enfoquesolarmx/ISLA_DEL_SOL_PUENTE_H-/hardware/puente_h/Disipador_V8511Y_equiv.step

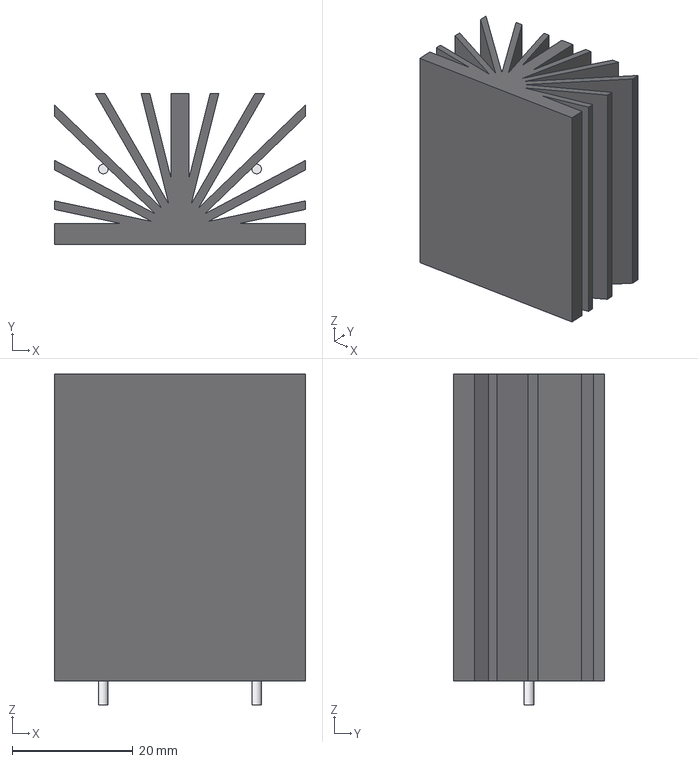
[picture p112: CAD file, 2026-11-05]
hardware/puente_h/Disipador_V8511Y_equiv.step
41.6 x 25.0 x 54.8 mm
disipador
pines
