enfoquesolarmx/ISLA_DEL_SOL_PUENTE_H-/hardware/transferencia_reles/3d/Relay_SPDT_RAYEX-L90S_aprox.step

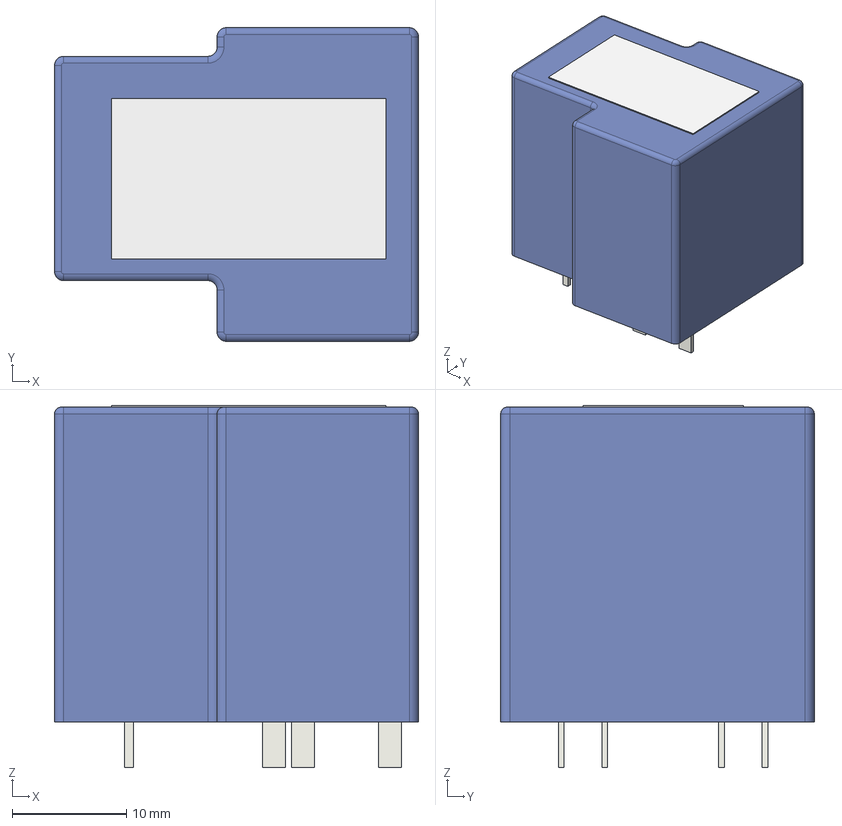
[picture p113: CAD file, 2026-11-11]
hardware/transferencia_reles/3d/Relay_SPDT_RAYEX-L90S_aprox.step
31.8 x 27.4 x 31.6 mm
cuerpo
marca
pines
