enfoquesolarmx/ISLA_DEL_SOL_PUENTE_H-/hardware/puente_h/Heatsink_Fischer_SK129-STS_50.8mm.step

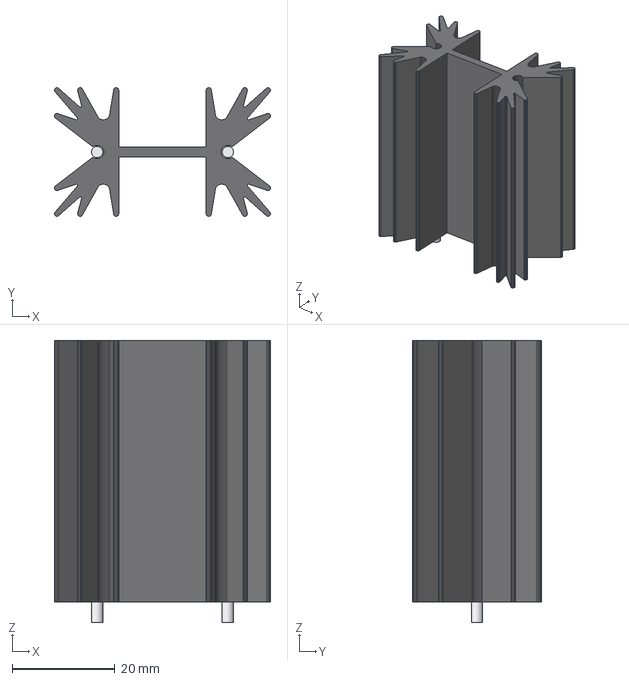
[picture p114: CAD file, 2026-11-05]
hardware/puente_h/Heatsink_Fischer_SK129-STS_50.8mm.step
42.0 x 25.0 x 54.8 mm
disipador
pines
