enfoquesolarmx/ISLA_DEL_SOL_PUENTE_H-/hardware/puente_h/SSA2512_Littelfuse.step

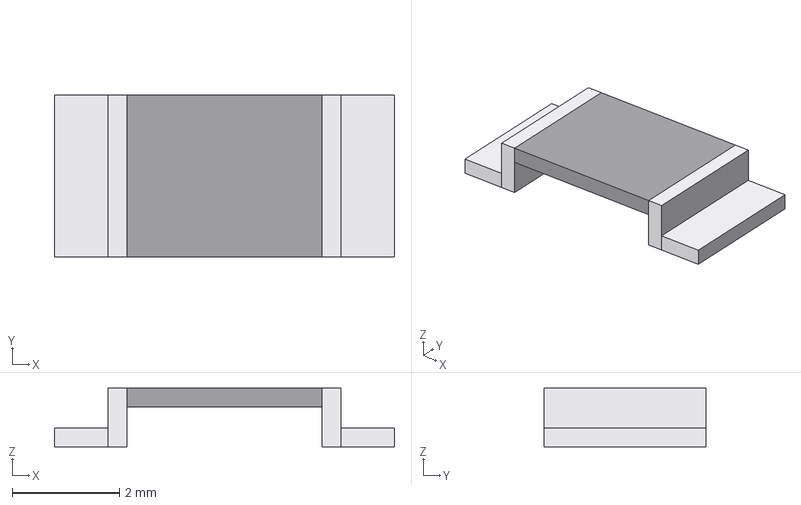
[picture p115: CAD file, 2026-11-05]
hardware/puente_h/SSA2512_Littelfuse.step
6.35 x 3.02 x 1.10 mm
term1
term2
riser1
riser2
elemento
