enfoquesolarmx/ISLA_DEL_SOL_PUENTE_H-/hardware/puente_h/PUENTE_H_INV48V_REV_C_2026-10_GATE_CENTRO.kicad_pcb

## KiCad design hardware/puente_h/PUENTE_H_INV48V_REV_C_2026-10_GATE_CENTRO.kicad_pcb (2026-11-12)

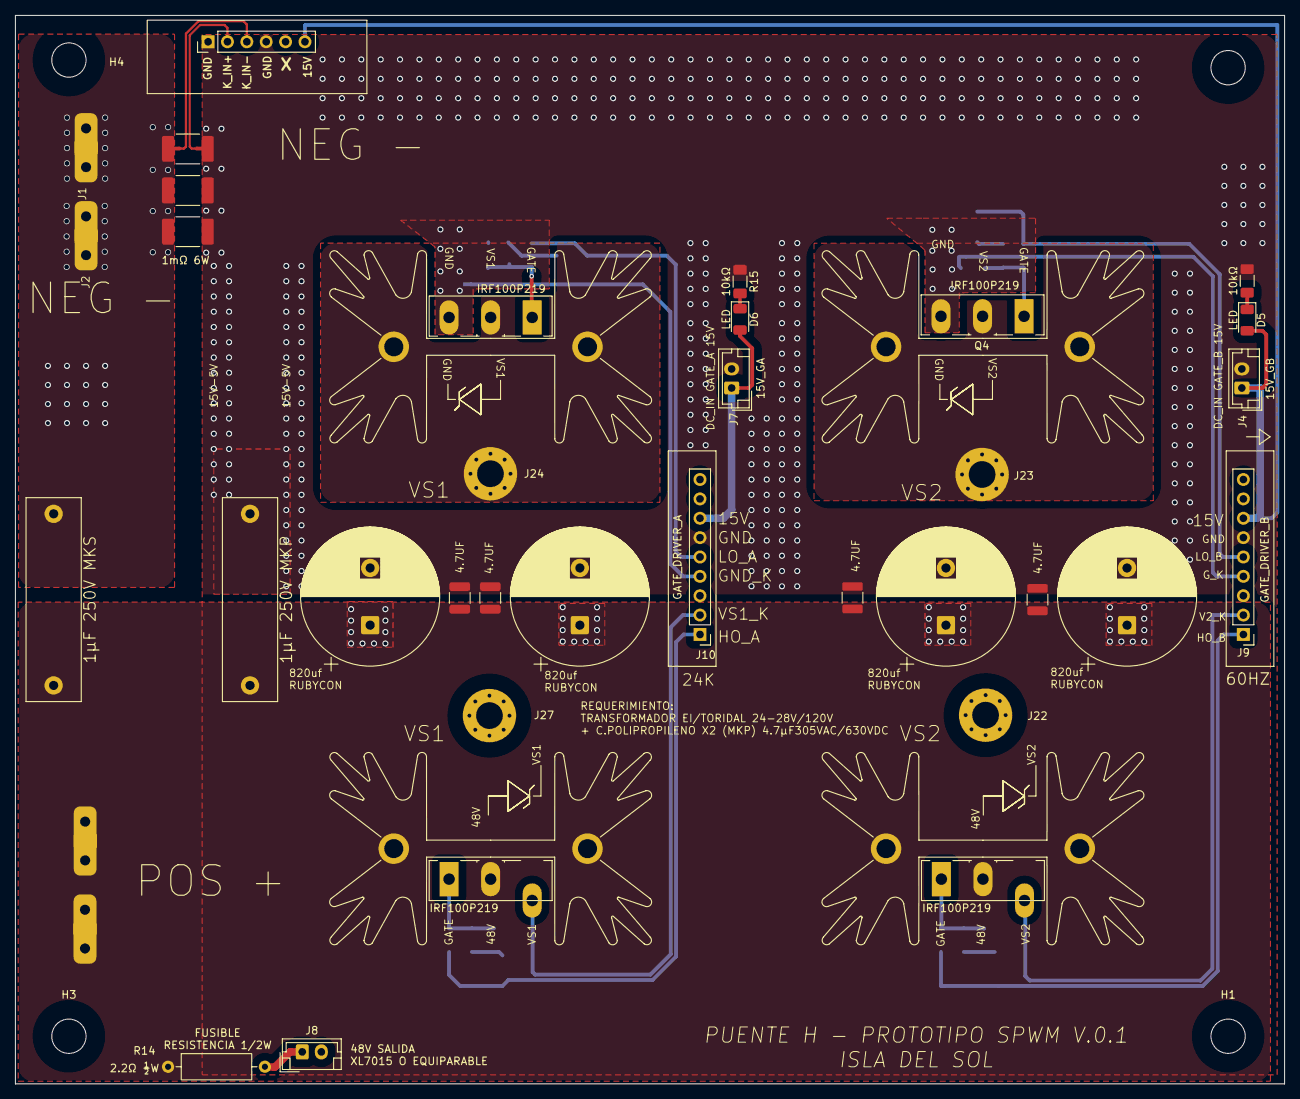
[picture p116: board PUENTE_H_INV48V_REV_C_2026-10_GATE_CENTRO.kicad_pcb from above]

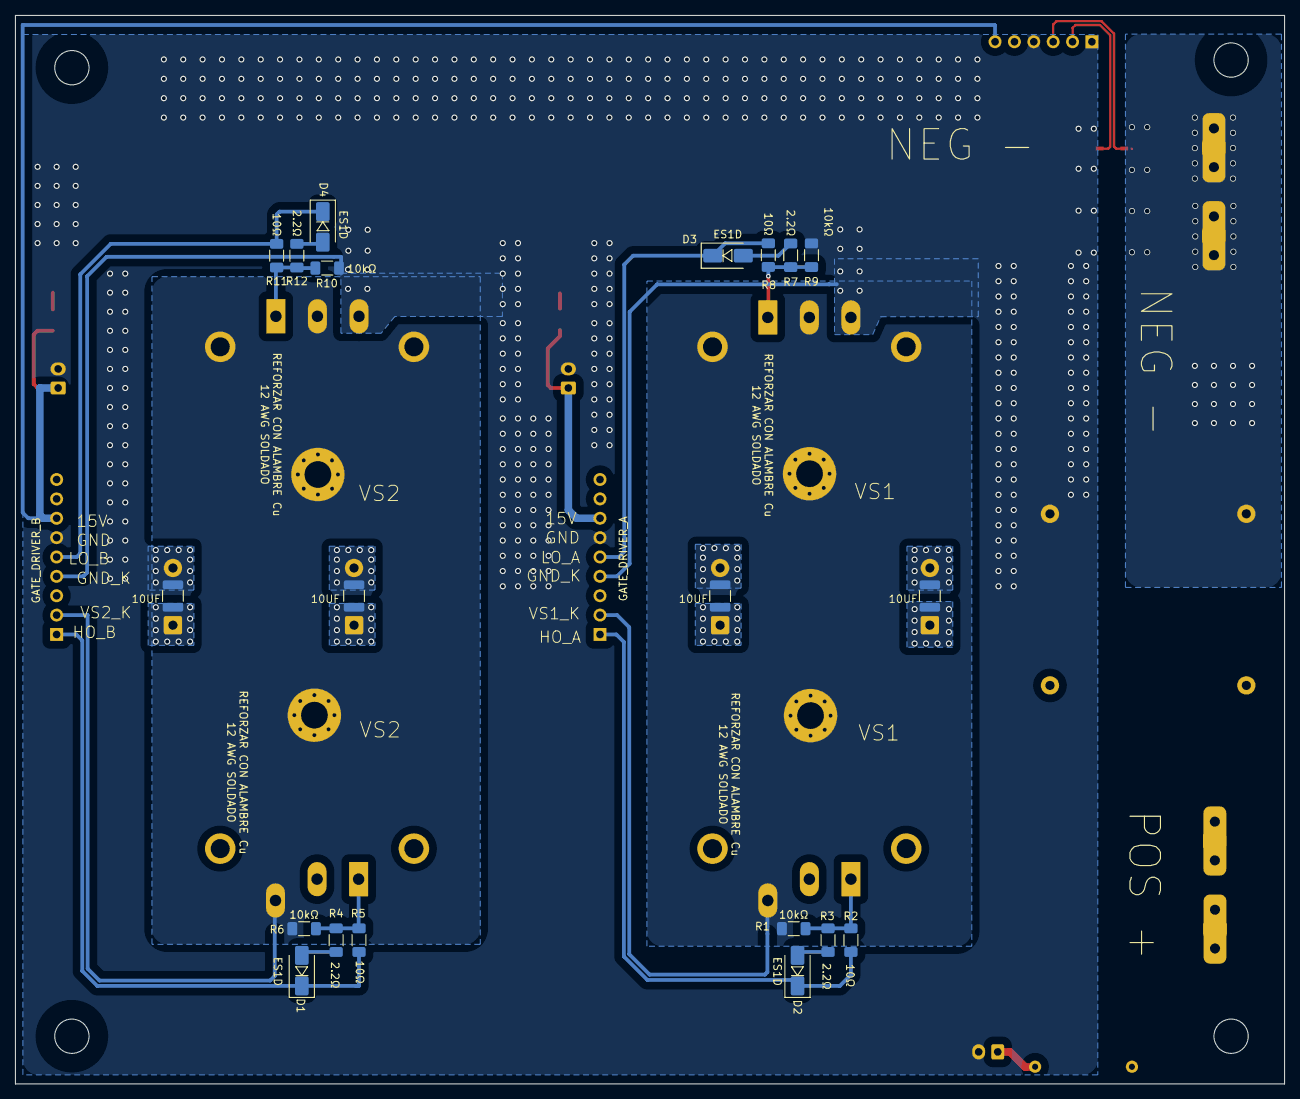
[picture p117: board PUENTE_H_INV48V_REV_C_2026-10_GATE_CENTRO.kicad_pcb from below]

Board: 2 copper layers, 166.4 x 140.1 mm, 70 parts (24 on the bottom side), 28 nets.

Parts:
C1, C2, C3, C4: 820µF 100V Rubycon ZLH; CP_Radial_D18.0mm_P7.50mm
C5, C6, C7, C8: 10µF 100V X7R; C_1210_3225Metric
C9: 1µF 250V MKP; C_Rect_L26.5mm_W7.0mm_P22.50mm_MKS4
C10: 1µF 250V MKS; C_Rect_L26.5mm_W7.0mm_P22.50mm_MKS4
C11, C12, C13, C14: 4.7µF 100V X7R; C_1210_3225Metric
D1, D2, D3, D4: ES1D; D_SMA
D5, D6: LED; LED_1206_3216Metric
H1, H2, H3, H4: MountingHole; MountingHole_4.5mm
HS5: DISIPADOR_1; Heatsink_Fischer_SK129-STS_42x25mm_2xDrill2.5mm
HS6: DISIPADOR_3; Heatsink_Fischer_SK129-STS_42x25mm_2xDrill2.5mm
HS7: DISIPADOR_2; Heatsink_Fischer_SK129-STS_42x25mm_2xDrill2.5mm
HS8: DISIPADOR_4; Heatsink_Fischer_SK129-STS_42x25mm_2xDrill2.5mm
J1, J2: BAT− (GND_IN); Faston 63823
J3: SENSOR_DC (llave en 5); PinHeader_1x06_P2.54mm_Vertical
J4: 15V_GB; JST_EH_B2B-EH-A_1x02_P2.50mm_Vertical
J5, J6: BAT+ (48V); Faston 63823
J7: 15V_GA; JST_EH_B2B-EH-A_1x02_P2.50mm_Vertical
J8: 48V → BUCK (≥80 V); JST_EH_B2B-EH-A_1x02_P2.50mm_Vertical
J9: GATE_DRIVER_B; PinHeader_1x09_P2.54mm_Vertical
J10: GATE_DRIVER_A; PinHeader_1x09_P2.54mm_Vertical
J22, J23: VS2; MountingHole_3.5mm_Pad_Via
J24, J27: VS1; MountingHole_3.5mm_Pad_Via
NT1, NT2, NT3, NT4, NT5, NT6: Kelvin; NetTie-2_SMD_Pad0.5mm
Q1, Q2, Q3, Q4: IRF100P219; TO-247-3_Vertical
R1, R6, R9, R10, R13, R15: 10kΩ; R_1206_3216Metric_Pad1.30x1.75mm_HandSolder
R2, R5, R8, R11: 10Ω; R_1206_3216Metric_Pad1.30x1.75mm_HandSolder
R3, R4, R7, R12: 2.2Ω; R_1206_3216Metric_Pad1.30x1.75mm_HandSolder
R14: 2.2Ω ½W; R_Axial_DIN0309_L9.0mm_D3.2mm_P12.70mm_Horizontal
R16: 1mΩ 6W (Kelvin, siempre); SSA2512_Littelfuse_Kelvin
R17: 1mΩ 6W (opcional); SSA2512_Littelfuse_Kelvin
R28: 1mΩ 6W; SSA2512_Littelfuse_Kelvin

Connections:
15V_GA: D6.2 (A), J7.1, J10.7
15V_GB: D5.2 (A), J3.6, J4.1, J9.7
48V: C1.1, C2.1, C3.1, C4.1, C5.1, C6.1, C7.1, C8.1, C9.1, C10.1, C11.1, C12.1, C13.1, C14.1, HS5.1, HS7.1, J5.1, J6.1, Q1.2 (D), Q3.2 (D), R14.1
GND: C1.2, C2.2, C3.2, C4.2, C5.2, C6.2, C7.2, C8.2, C9.2, C11.2, C12.2, C13.2, C14.2, J3.1, J3.4, J4.2, J7.2, J8.2, J9.6, J10.6, NT1.2, NT2.2, NT5.2, Q2.3 (S), Q4.3 (S), R9.2, R10.2, R13.1, R15.1, R16.2, R17.2, R28.2
GND_IN: C10.2, J1.1, J2.1, NT6.2, R16.1, R17.1, R28.1
GND_KELVIN_A: J10.4, NT2.1
GND_KELVIN_B: J9.4, NT1.1
HO_A: D2.1 (K), J10.1, R2.1
HO_B: D1.1 (K), J9.1, R5.1
IN+ (Kelvin): J3.2, NT5.1
IN- (Kelvin): J3.3, NT6.1
LO_A: D3.1 (K), J10.5, R8.1
LO_B: D4.1 (K), J9.5, R11.1
unnamed: D1.2 (A), R4.1
unnamed: D2.2 (A), R3.1
unnamed: D3.2 (A), R7.1
unnamed: D4.2 (A), R12.1
unnamed: D5.1 (K), R13.2
unnamed: D6.1 (K), R15.2
unnamed: J8.1, R14.2
unnamed: Q1.1 (G), R1.1, R2.2, R3.2
unnamed: Q2.1 (G), R7.2, R8.2, R9.1
unnamed: Q3.1 (G), R4.2, R5.2, R6.1
unnamed: Q4.1 (G), R10.1, R11.2, R12.2
VS1: HS6.1, J24.1, J27.1, NT4.2, Q1.3 (S), Q2.2 (D), R1.2
VS1_k: J10.2, NT4.1
VS2: HS8.1, J22.1, J23.1, NT3.2, Q3.3 (S), Q4.2 (D), R6.2
VS2_k: J9.2, NT3.1
