enfoquesolarmx/ISLA_DEL_SOL_PUENTE_H-/hardware/gate-drivers/ucc21520/GATE_DRIVER_UCC21520.kicad_pcb

## KiCad design hardware/gate-drivers/ucc21520/GATE_DRIVER_UCC21520.kicad_pcb (2026-11-12)

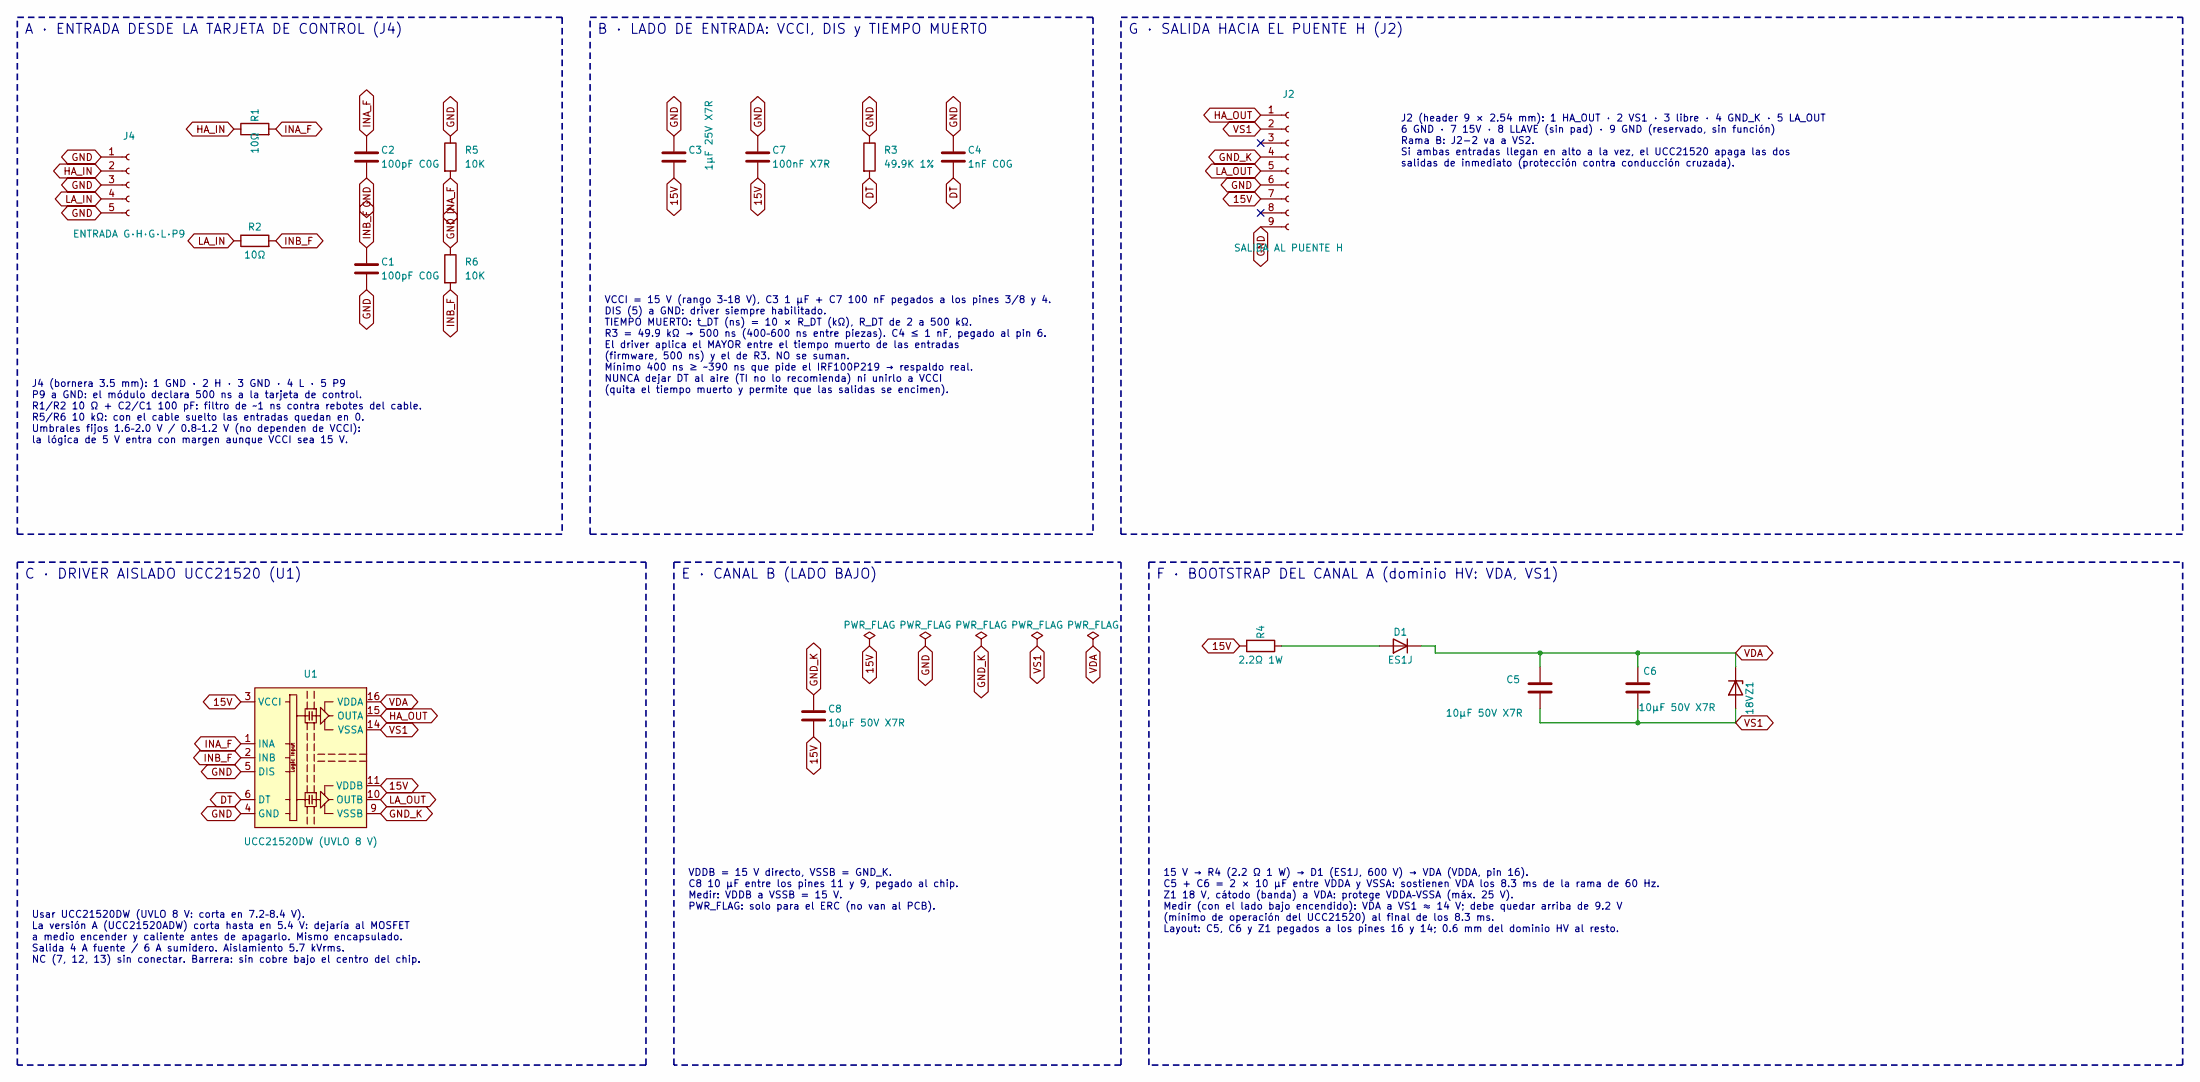
[picture p118: schematic GATE_DRIVER_UCC21520.kicad_sch]

Parts:
C1, C2: 100pF C0G; C_1206_3216Metric
C3: 1µF 25V X7R; C_1206_3216Metric
C4: 1nF C0G; C_1206_3216Metric
C5, C6, C8: 10µF 50V X7R; C_1206_3216Metric
C7: 100nF X7R; C_1206_3216Metric
D1: ES1J; D_SMA
J2: SALIDA AL PUENTE H; PinHeader_1x09_P2.54mm_Vertical
J4: ENTRADA G·H·G·L·P9; PhoenixContact_SPT_1.5_5-H-3.5_1x05_P3.5mm_Horizontal
R1, R2: 10Ω; R_1206_3216Metric
R3: 49.9K 1%; R_1206_3216Metric
R4: 2.2Ω 1W; R_1210_3225Metric_Pad1.30x2.65mm_HandSolder
R5, R6: 10K; R_1206_3216Metric
U1: UCC21520DW (UVLO 8 V); SOIC-16W_7.5x10.3mm_P1.27mm
Z1: 18V; D_SMA

Connections:
15V: C3.2, C7.2, C8.2, J2.7, R4.2, U1.3 (VCCI), U1.8 (VCCI), U1.11 (VDDB)
DT: C4.2, R3.2, U1.6 (DT)
GND: C1.2, C2.2, C3.1, C4.1, C7.1, J2.6, J2.9, J4.1, J4.3, J4.5, R3.1, R5.1, R6.1, U1.4 (GND), U1.5 (DIS)
GND_K: C8.1, J2.4, U1.9 (VSSB)
HA_IN: J4.2, R1.1
HA_OUT: J2.1, U1.15 (OUTA)
INA_F: C2.1, R1.2, R5.2, U1.1 (INA)
INB_F: C1.1, R2.2, R6.2, U1.2 (INB)
LA_IN: J4.4, R2.1
LA_OUT: J2.5, U1.10 (OUTB)
unnamed: D1.2 (A), R4.1
VDA: C5.2, C6.2, D1.1 (K), U1.16 (VDDA), Z1.1 (K)
VS1: C5.1, C6.1, J2.2, U1.14 (VSSA), Z1.2 (A)

Notes on the sheet:
VCCI = 15 V (rango 3–18 V), C3 1 µF + C7 100 nF pegados a los pines 3/8 y 4. DIS (5) a GND: driver siempre habilitado. TIEMPO MUERTO: t_DT (ns) = 10 × R_DT (kΩ), R_DT de 2 a 500 kΩ. R3 = 49.9 kΩ → 500 ns (400–600 ns entre piezas). C4 ≤ 1 nF, pegado al pin 6. El driver aplica el MAYOR entre el tiemp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
15 V → R4 (2.2 Ω 1 W) → D1 (ES1J, 600 V) → VDA (VDDA, pin 16). C5 + C6 = 2 × 10 µF entre VDDA y VSSA: sostienen VDA los 8.3 ms de la rama de 60 Hz. Z1 18 V, cátodo (banda) a VDA: protege VDDA–VSSA (máx. 25 V). Medir (con el lado bajo encendido): VDA a VS1 ≈ 14 V; debe quedar arriba de 9.2 V (mínimo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
B · LADO DE ENTRADA: VCCI, DIS y TIEMPO MUERTO
A · ENTRADA DESDE LA TARJETA DE CONTROL (J4)
J2 (header 9 × 2.54 mm): 1 HA_OUT · 2 VS1 · 3 libre · 4 GND_K · 5 LA_OUT 6 GND · 7 15V · 8 LLAVE (sin pad) · 9 GND (reservado, sin función) Rama B: J2-2 va a VS2. Si ambas entradas llegan en alto a la vez, el UCC21520 apaga las dos salidas de inmediato (protección contra conducción cruzada).
F · BOOTSTRAP DEL CANAL A (dominio HV: VDA, VS1)
E · CANAL B (LADO BAJO)
VDDB = 15 V directo, VSSB = GND_K. C8 10 µF entre los pines 11 y 9, pegado al chip. Medir: VDDB a VSSB = 15 V. PWR_FLAG: solo para el ERC (no van al PCB).
C · DRIVER AISLADO UCC21520 (U1)
J4 (bornera 3.5 mm): 1 GND · 2 H · 3 GND · 4 L · 5 P9 P9 a GND: el módulo declara 500 ns a la tarjeta de control. R1/R2 10 Ω + C2/C1 100 pF: filtro de ~1 ns contra rebotes del cable. R5/R6 10 kΩ: con el cable suelto las entradas quedan en 0. Umbrales fijos 1.6–2.0 V / 0.8–1.2 V (no dependen de VCCI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
Usar UCC21520DW (UVLO 8 V: corta en 7.2–8.4 V). La versión A (UCC21520ADW) corta hasta en 5.4 V: dejaría al MOSFET a medio encender y caliente antes de apagarlo. Mismo encapsulado. Salida 4 A fuente / 6 A sumidero. Aislamiento 5.7 kVrms. NC (7, 12, 13) sin conectar. Barrera: sin cobre bajo el centr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
G · SALIDA HACIA EL PUENTE H (J2)

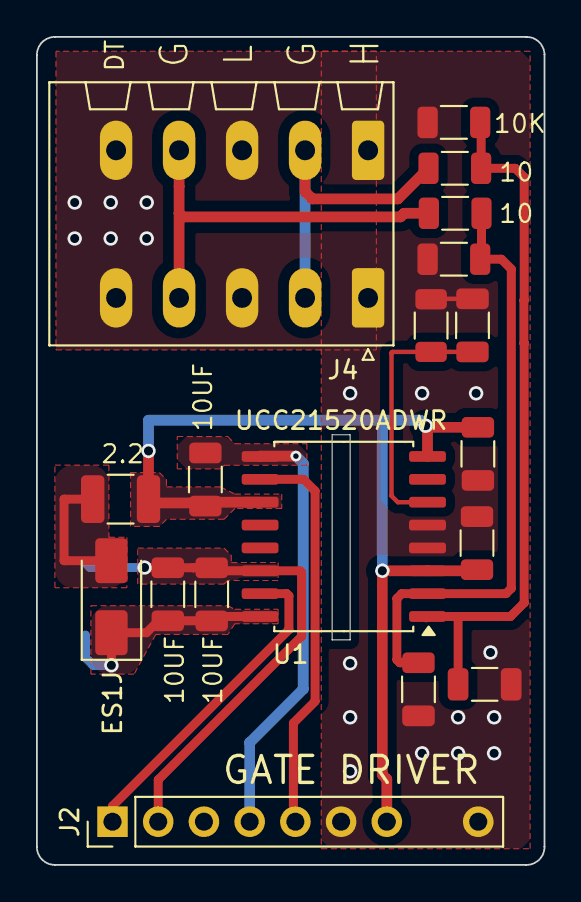
[picture p119: board GATE_DRIVER_UCC21520.kicad_pcb from above]

Board: 2 copper layers, 28.2 x 46.0 mm, 19 parts (1 on the bottom side), 13 nets.
