enfoquesolarmx/ISLA_DEL_SOL_PUENTE_H-/hardware/gate-drivers/tlp250-trinchera/GATE_TLP_250_TOTEM_TIP.kicad_pcb

## KiCad design hardware/gate-drivers/tlp250-trinchera/GATE_TLP_250_TOTEM_TIP.kicad_pcb (2026-11-12)

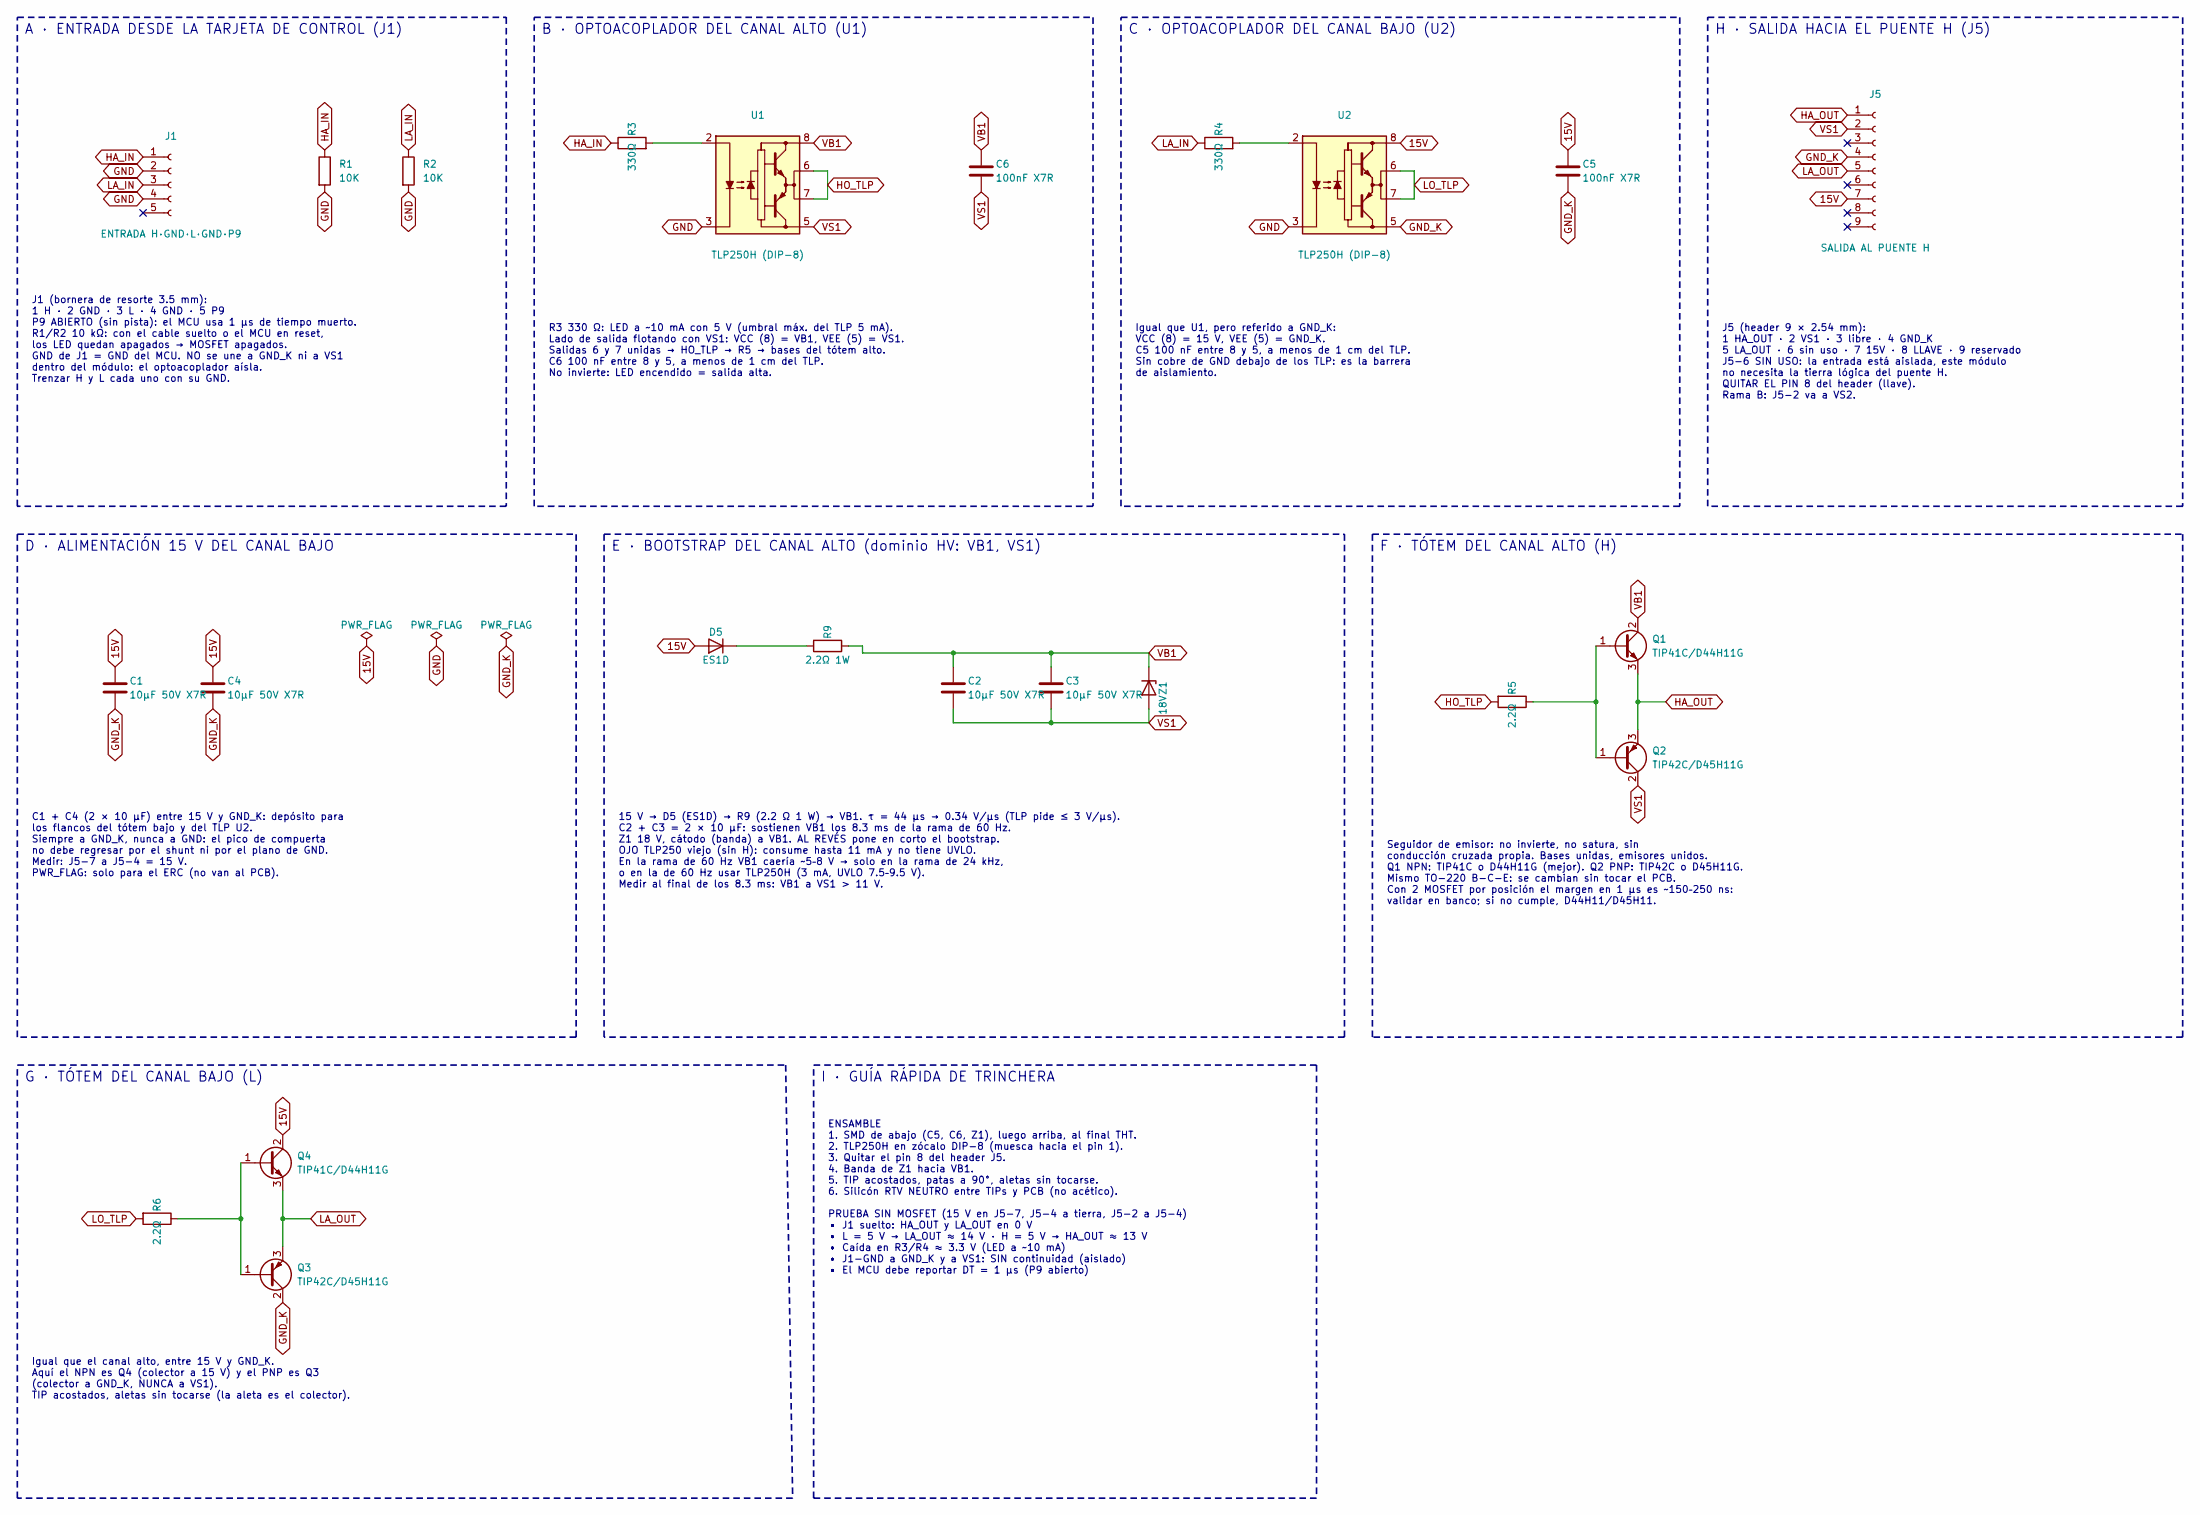
[picture p120: schematic GATE_TLP_250_TOTEM_TIP.kicad_sch]

Parts:
C1, C2, C3, C4: 10µF 50V X7R; C_1206_3216Metric
C5, C6: 100nF X7R; C_1206_3216Metric
D5: ES1D; D_SMA
J1: ENTRADA H·GND·L·GND·P9; PhoenixContact_SPT_1.5_5-H-3.5_1x05_P3.5mm_Horizontal
J5: SALIDA AL PUENTE H; PinHeader_1x09_P2.54mm_Vertical
Q1, Q4: TIP41C/D44H11G; TO-220-3_Vertical
Q2, Q3: TIP42C/D45H11G; TO-220-3_Vertical
R1, R2: 10K; R_1206_3216Metric_Pad1.30x1.75mm_HandSolder
R3, R4: 330Ω; R_1206_3216Metric_Pad1.30x1.75mm_HandSolder
R5, R6: 2.2Ω; R_1206_3216Metric_Pad1.30x1.75mm_HandSolder
R9: 2.2Ω 1W; R_1210_3225Metric
U1, U2: TLP250H (DIP-8); DIP-8_W7.62mm
Z1: 18V; D_SMA

Connections:
15V: C1.1, C4.1, C5.1, D5.2 (A), J5.7, Q4.2 (C), U2.8 (VCC)
GND: J1.2, J1.4, R1.2, R2.2, U1.3 (C), U2.3 (C)
GND_K: C1.2, C4.2, C5.2, J5.4, Q3.2 (C), U2.5 (VEE)
HA_IN: J1.1, R1.1, R3.1
HA_OUT: J5.1, Q1.3 (E), Q2.3 (E)
HO_TLP: R5.2, U1.6 (VO), U1.7 (VO)
LA_IN: J1.3, R2.1, R4.1
LA_OUT: J5.5, Q3.3 (E), Q4.3 (E)
LO_TLP: R6.2, U2.6 (VO), U2.7 (VO)
unnamed: D5.1 (K), R9.2
unnamed: Q1.1 (B), Q2.1 (B), R5.1
unnamed: Q3.1 (B), Q4.1 (B), R6.1
unnamed: R3.2, U1.2 (A)
unnamed: R4.2, U2.2 (A)
VB1: C2.1, C3.1, C6.1, Q1.2 (C), R9.1, U1.8 (VCC), Z1.1 (K)
VS1: C2.2, C3.2, C6.2, J5.2, Q2.2 (C), U1.5 (VEE), Z1.2 (A)

Notes on the sheet:
H · SALIDA HACIA EL PUENTE H (J5)
J5 (header 9 × 2.54 mm): 1 HA_OUT · 2 VS1 · 3 libre · 4 GND_K 5 LA_OUT · 6 sin uso · 7 15V · 8 LLAVE · 9 reservado J5-6 SIN USO: la entrada está aislada, este módulo no necesita la tierra lógica del puente H. QUITAR EL PIN 8 del header (llave). Rama B: J5-2 va a VS2.
C1 + C4 (2 × 10 µF) entre 15 V y GND_K: depósito para los flancos del tótem bajo y del TLP U2. Siempre a GND_K, nunca a GND: el pico de compuerta no debe regresar por el shunt ni por el plano de GND. Medir: J5-7 a J5-4 = 15 V. PWR_FLAG: solo para el ERC (no van al PCB).
A · ENTRADA DESDE LA TARJETA DE CONTROL (J1)
D · ALIMENTACIÓN 15 V DEL CANAL BAJO
E · BOOTSTRAP DEL CANAL ALTO (dominio HV: VB1, VS1)
15 V → D5 (ES1D) → R9 (2.2 Ω 1 W) → VB1. τ = 44 µs → 0.34 V/µs (TLP pide ≤ 3 V/µs). C2 + C3 = 2 × 10 µF: sostienen VB1 los 8.3 ms de la rama de 60 Hz. Z1 18 V, cátodo (banda) a VB1. AL REVÉS pone en corto el bootstrap. OJO TLP250 viejo (sin H): consume hasta 11 mA y no tiene UVLO. En la rama de 60 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
Igual que el canal alto, entre 15 V y GND_K. Aquí el NPN es Q4 (colector a 15 V) y el PNP es Q3 (colector a GND_K, NUNCA a VS1). TIP acostados, aletas sin tocarse (la aleta es el colector).
J1 (bornera de resorte 3.5 mm): 1 H · 2 GND · 3 L · 4 GND · 5 P9 P9 ABIERTO (sin pista): el MCU usa 1 µs de tiempo muerto. R1/R2 10 kΩ: con el cable suelto o el MCU en reset, los LED quedan apagados → MOSFET apagados. GND de J1 = GND del MCU. NO se une a GND_K ni a VS1 dentro del módulo: el optoaco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
F · TÓTEM DEL CANAL ALTO (H)
B · OPTOACOPLADOR DEL CANAL ALTO (U1)
ENSAMBLE 1. SMD de abajo (C5, C6, Z1), luego arriba, al final THT. 2. TLP250H en zócalo DIP-8 (muesca hacia el pin 1). 3. Quitar el pin 8 del header J5. 4. Banda de Z1 hacia VB1. 5. TIP acostados, patas a 90°, aletas sin tocarse. 6. Silicón RTV NEUTRO entre TIPs y PCB (no acético). PRUEBA SIN MOSFE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
C · OPTOACOPLADOR DEL CANAL BAJO (U2)
Igual que U1, pero referido a GND_K: VCC (8) = 15 V, VEE (5) = GND_K. C5 100 nF entre 8 y 5, a menos de 1 cm del TLP. Sin cobre de GND debajo de los TLP: es la barrera de aislamiento.
R3 330 Ω: LED a ~10 mA con 5 V (umbral máx. del TLP 5 mA). Lado de salida flotando con VS1: VCC (8) = VB1, VEE (5) = VS1. Salidas 6 y 7 unidas → HO_TLP → R5 → bases del tótem alto. C6 100 nF entre 8 y 5, a menos de 1 cm del TLP. No invierte: LED encendido = salida alta.
I · GUÍA RÁPIDA DE TRINCHERA
G · TÓTEM DEL CANAL BAJO (L)
Seguidor de emisor: no invierte, no satura, sin conducción cruzada propia. Bases unidas, emisores unidos. Q1 NPN: TIP41C o D44H11G (mejor). Q2 PNP: TIP42C o D45H11G. Mismo TO-220 B-C-E: se cambian sin tocar el PCB. Con 2 MOSFET por posición el margen en 1 µs es ~150–250 ns: validar en banco; si no 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

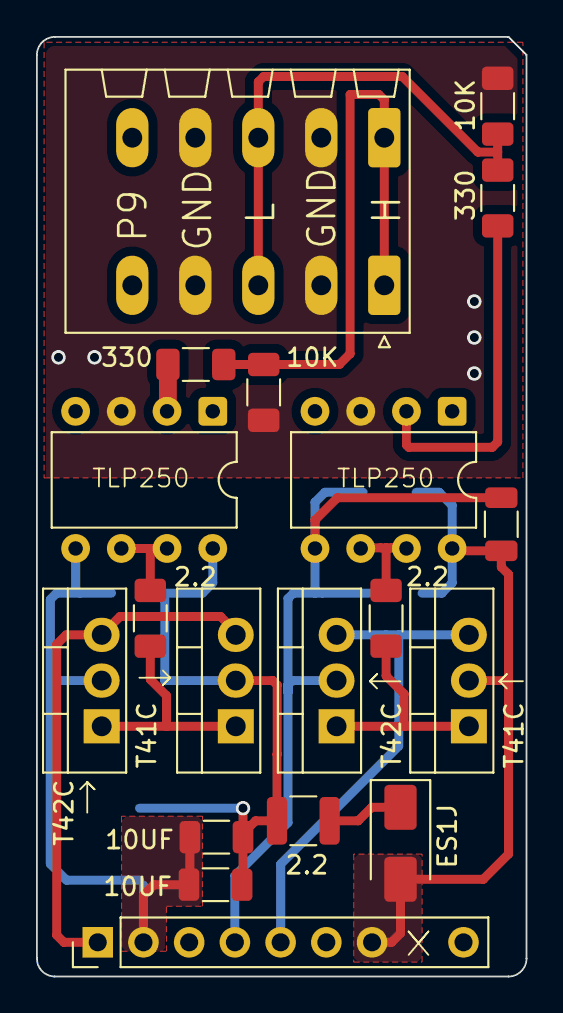
[picture p121: board GATE_TLP_250_TOTEM_TIP.kicad_pcb from above]

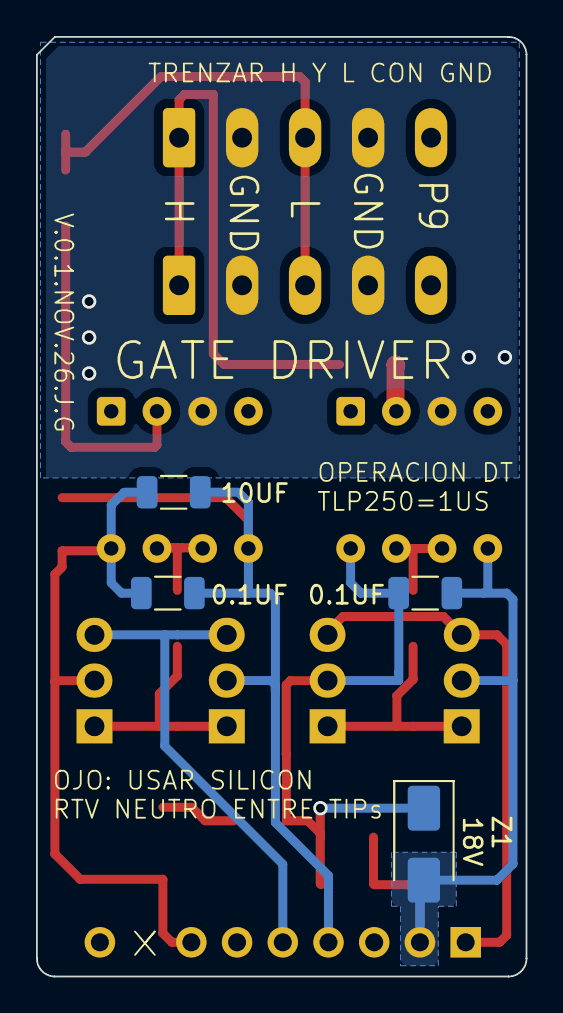
[picture p122: board GATE_TLP_250_TOTEM_TIP.kicad_pcb from below]

Board: 2 copper layers, 27.2 x 52.2 mm, 23 parts (4 on the bottom side), 16 nets.
