enfoquesolarmx/ISLA_DEL_SOL_PUENTE_H-/hardware/gate-drivers/ir2110-trinchera/GATE_DRIVER_IR2110_TOTEM.kicad_pcb

## KiCad design hardware/gate-drivers/ir2110-trinchera/GATE_DRIVER_IR2110_TOTEM.kicad_pcb (2026-11-12)

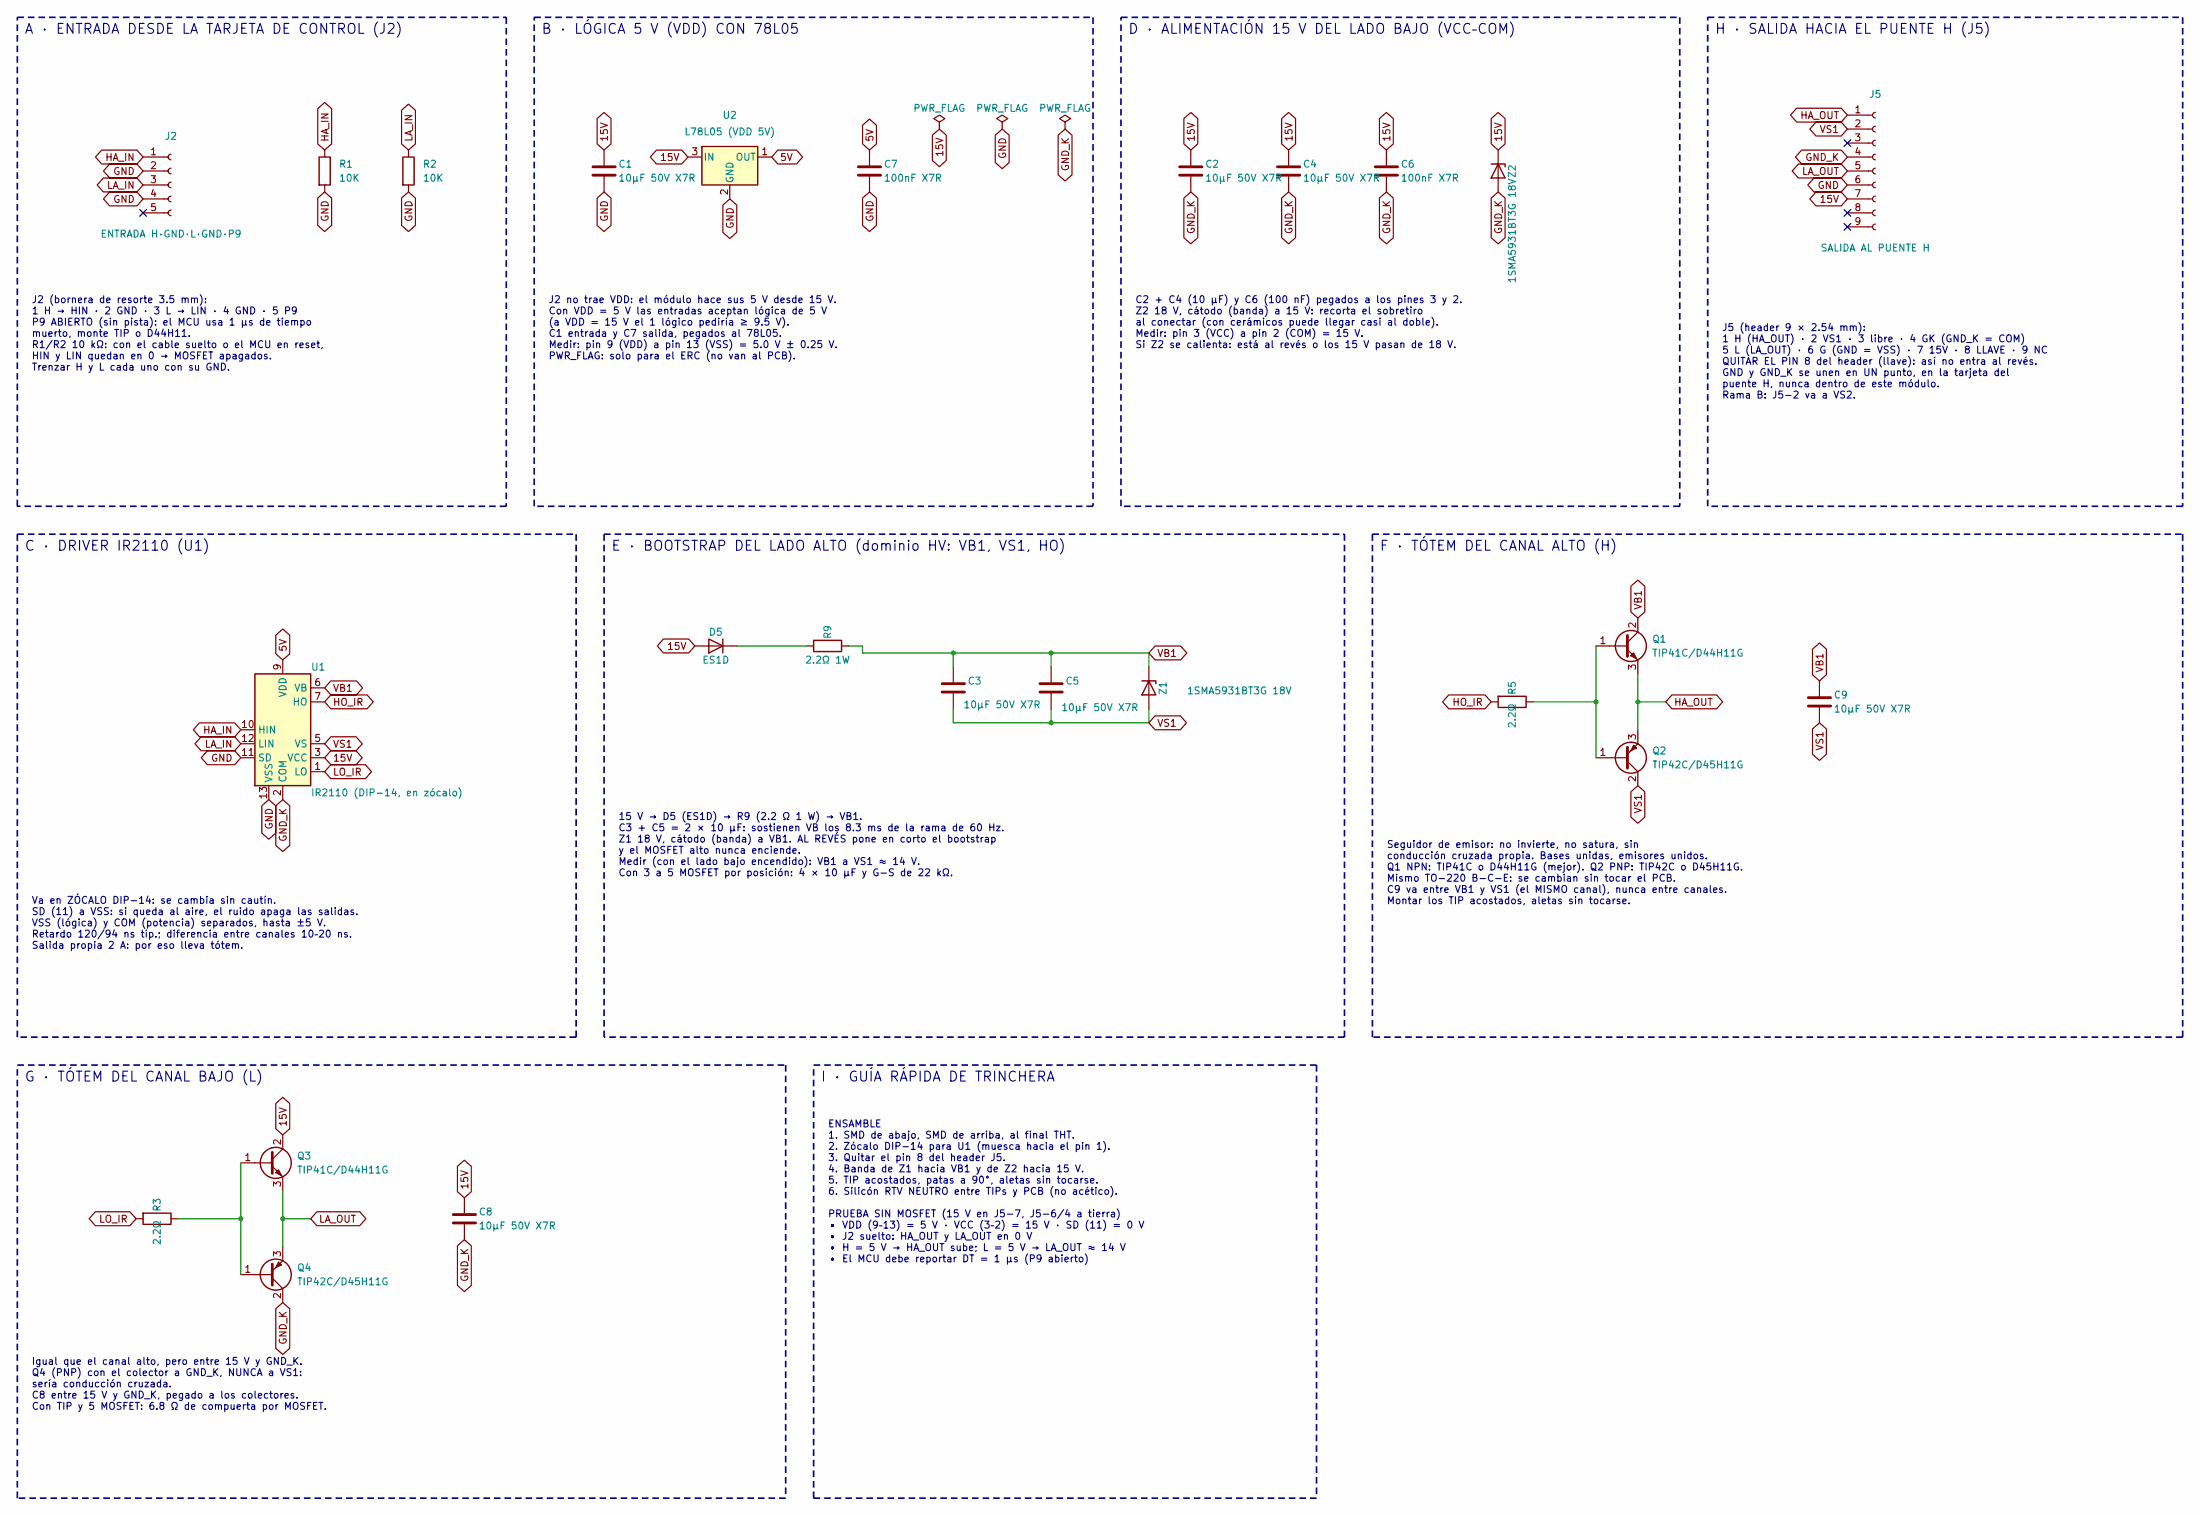
[picture p123: schematic GATE_DRIVER_IR2110_TOTEM.kicad_sch]

Parts:
C1, C2, C3, C4, C5, C8, C9: 10µF 50V X7R; C_1210_3225Metric_Pad1.33x2.70mm_HandSolder
C6, C7: 100nF X7R; C_1206_3216Metric
D5: ES1D; D_SMA
J2: ENTRADA H·GND·L·GND·P9; PhoenixContact_SPT_1.5_5-H-3.5_1x05_P3.5mm_Horizontal
J5: SALIDA AL PUENTE H; PinHeader_1x09_P2.54mm_Vertical
Q1, Q3: TIP41C/D44H11G; TO-220-3_Vertical
Q2, Q4: TIP42C/D45H11G; TO-220-3_Vertical
R1, R2: 10K; R_1206_3216Metric_Pad1.30x1.75mm_HandSolder
R3, R5: 2.2Ω; R_1206_3216Metric_Pad1.30x1.75mm_HandSolder
R9: 2.2Ω 1W; R_1210_3225Metric
U1: IR2110 (DIP-14, en zócalo); DIP-14_W7.62mm
U2: L78L05 (VDD 5V); SOT-89-3
Z1, Z2: 1SMA5931BT3G 18V; D_SMA

Connections:
5V: C7.1, U1.9 (VDD), U2.1 (OUT)
15V: C1.1, C2.1, C4.1, C6.1, C8.1, D5.2 (A), J5.7, Q3.2 (C), U1.3 (VCC), U2.3 (IN), Z2.1 (K)
GND: C1.2, C7.2, J2.2, J2.4, J5.6, R1.2, R2.2, U1.11 (SD), U1.13 (VSS), U2.2 (GND)
GND_K: C2.2, C4.2, C6.2, C8.2, J5.4, Q4.2 (C), U1.2 (COM), Z2.2 (A)
HA_IN: J2.1, R1.1, U1.10 (HIN)
HA_OUT: J5.1, Q1.3 (E), Q2.3 (E)
HO_IR: R5.2, U1.7 (HO)
LA_IN: J2.3, R2.1, U1.12 (LIN)
LA_OUT: J5.5, Q3.3 (E), Q4.3 (E)
LO_IR: R3.2, U1.1 (LO)
unnamed: D5.1 (K), R9.2
unnamed: Q1.1 (B), Q2.1 (B), R5.1
unnamed: Q3.1 (B), Q4.1 (B), R3.1
VB1: C3.1, C5.1, C9.1, Q1.2 (C), R9.1, U1.6 (VB), Z1.1 (K)
VS1: C3.2, C5.2, C9.2, J5.2, Q2.2 (C), U1.5 (VS), Z1.2 (A)

Notes on the sheet:
H · SALIDA HACIA EL PUENTE H (J5)
ENSAMBLE 1. SMD de abajo, SMD de arriba, al final THT. 2. Zócalo DIP-14 para U1 (muesca hacia el pin 1). 3. Quitar el pin 8 del header J5. 4. Banda de Z1 hacia VB1 y de Z2 hacia 15 V. 5. TIP acostados, patas a 90°, aletas sin tocarse. 6. Silicón RTV NEUTRO entre TIPs y PCB (no acético). PRUEBA SIN 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
I · GUÍA RÁPIDA DE TRINCHERA
C2 + C4 (10 µF) y C6 (100 nF) pegados a los pines 3 y 2. Z2 18 V, cátodo (banda) a 15 V: recorta el sobretiro al conectar (con cerámicos puede llegar casi al doble). Medir: pin 3 (VCC) a pin 2 (COM) = 15 V. Si Z2 se calienta: está al revés o los 15 V pasan de 18 V.
E · BOOTSTRAP DEL LADO ALTO (dominio HV: VB1, VS1, HO)
A · ENTRADA DESDE LA TARJETA DE CONTROL (J2)
F · TÓTEM DEL CANAL ALTO (H)
Seguidor de emisor: no invierte, no satura, sin conducción cruzada propia. Bases unidas, emisores unidos. Q1 NPN: TIP41C o D44H11G (mejor). Q2 PNP: TIP42C o D45H11G. Mismo TO-220 B-C-E: se cambian sin tocar el PCB. C9 va entre VB1 y VS1 (el MISMO canal), nunca entre canales. Montar los TIP acostado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
B · LÓGICA 5 V (VDD) CON 78L05
Igual que el canal alto, pero entre 15 V y GND_K. Q4 (PNP) con el colector a GND_K, NUNCA a VS1: sería conducción cruzada. C8 entre 15 V y GND_K, pegado a los colectores. Con TIP y 5 MOSFET: 6.8 Ω de compuerta por MOSFET.
D · ALIMENTACIÓN 15 V DEL LADO BAJO (VCC–COM)
Va en ZÓCALO DIP-14: se cambia sin cautín. SD (11) a VSS: si queda al aire, el ruido apaga las salidas. VSS (lógica) y COM (potencia) separados, hasta ±5 V. Retardo 120/94 ns típ.; diferencia entre canales 10–20 ns. Salida propia 2 A: por eso lleva tótem.
G · TÓTEM DEL CANAL BAJO (L)
C · DRIVER IR2110 (U1)
15 V → D5 (ES1D) → R9 (2.2 Ω 1 W) → VB1. C3 + C5 = 2 × 10 µF: sostienen VB los 8.3 ms de la rama de 60 Hz. Z1 18 V, cátodo (banda) a VB1. AL REVÉS pone en corto el bootstrap y el MOSFET alto nunca enciende. Medir (con el lado bajo encendido): VB1 a VS1 ≈ 14 V. Con 3 a 5 MOSFET por posición: 4 × 10 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
J5 (header 9 × 2.54 mm): 1 H (HA_OUT) · 2 VS1 · 3 libre · 4 GK (GND_K = COM) 5 L (LA_OUT) · 6 G (GND = VSS) · 7 15V · 8 LLAVE · 9 NC QUITAR EL PIN 8 del header (llave): así no entra al revés. GND y GND_K se unen en UN punto, en la tarjeta del puente H, nunca dentro de este módulo. Rama B: J5-2 va a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
J2 (bornera de resorte 3.5 mm): 1 H → HIN · 2 GND · 3 L → LIN · 4 GND · 5 P9 P9 ABIERTO (sin pista): el MCU usa 1 µs de tiempo muerto, monte TIP o D44H11. R1/R2 10 kΩ: con el cable suelto o el MCU en reset, HIN y LIN quedan en 0 → MOSFET apagados. Trenzar H y L cada uno con su GND.
J2 no trae VDD: el módulo hace sus 5 V desde 15 V. Con VDD = 5 V las entradas aceptan lógica de 5 V (a VDD = 15 V el 1 lógico pediría ≥ 9.5 V). C1 entrada y C7 salida, pegados al 78L05. Medir: pin 9 (VDD) a pin 13 (VSS) = 5.0 V ± 0.25 V. PWR_FLAG: solo para el ERC (no van al PCB).

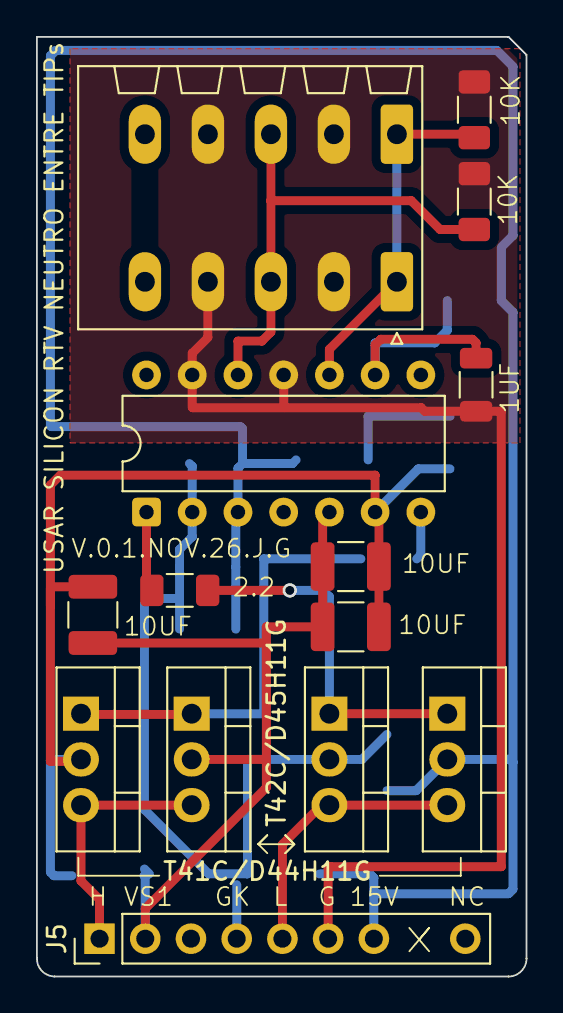
[picture p124: board GATE_DRIVER_IR2110_TOTEM.kicad_pcb from above]

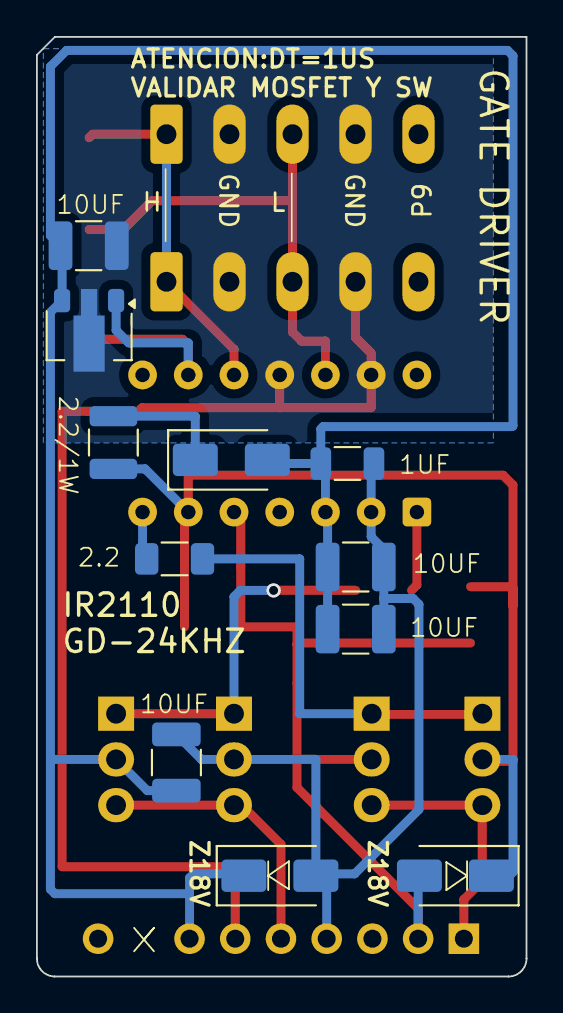
[picture p125: board GATE_DRIVER_IR2110_TOTEM.kicad_pcb from below]

Board: 2 copper layers, 27.2 x 52.2 mm, 25 parts (11 on the bottom side), 15 nets.
