enfoquesolarmx/ISLA_DEL_SOL_PUENTE_H-/hardware/gate-drivers/irs2186/GATE_DRIVER_IRS2186.kicad_pcb

## KiCad design hardware/gate-drivers/irs2186/GATE_DRIVER_IRS2186.kicad_pcb (2026-11-12)

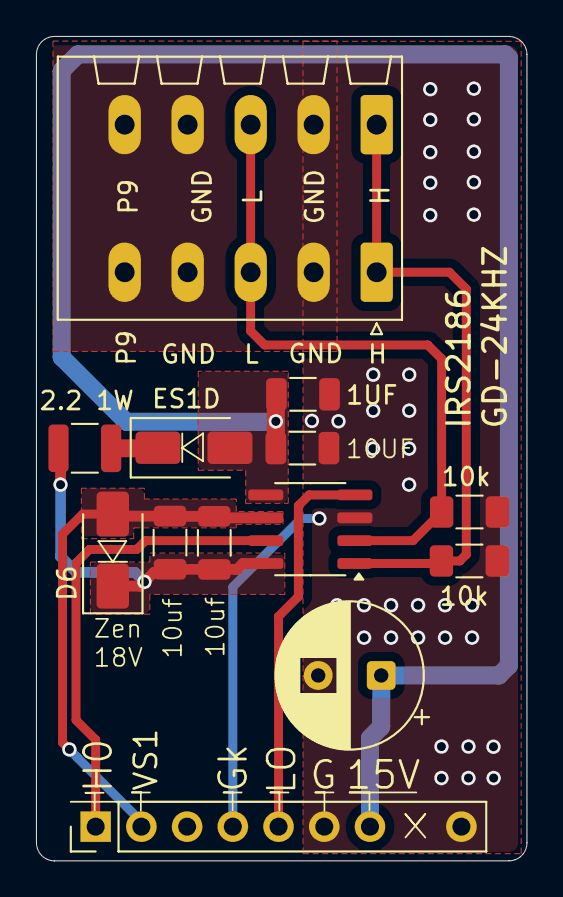
[picture p126: board GATE_DRIVER_IRS2186.kicad_pcb from above]

Board: 2 copper layers, 27.2 x 45.8 mm, 14 parts (1 on the bottom side), 10 nets.

Parts:
C1: 10UF; C_1206_3216Metric
C2, C9: 10uf; C_1206_3216Metric
C3: 47/100uf; CP_Radial_D8.0mm_P3.50mm
C4: 1UF; C_1206_3216Metric
D5: ES1D; D_SMA
D6: 18V; D_SMA
J1: SPWM; PhoenixContact_SPT_1.5_5-H-3.5_1x05_P3.5mm_Horizontal
J5: GATE_DRIVER_A; PinHeader_1x09_P2.54mm_Vertical
NT1: NetTie_2; NetTie-2_SMD_Pad0.5mm
R1, R2: 10K; R_1206_3216Metric_Pad1.30x1.75mm_HandSolder
R9: 2.2 1W; R_1210_3225Metric
U1: IRS2186; SOIC-8_3.9x4.9mm_P1.27mm

Connections:
15V: C1.1, C3.1, C4.1, D5.2 (A), J5.7, U1.5 (VCC)
GND: C1.2, C3.2, C4.2, J1.2, J1.4, J1.5, J5.6, J5.9, NT1.2, R1.2, R2.2, U1.3 (COM)
GND_K: J5.4, NT1.1
HA_IN: J1.1, R1.1, U1.1 (HIN)
HA_OUT: J5.1, U1.7 (HO)
LA_IN: J1.3, R2.1, U1.2 (LIN)
LA_OUT: J5.5, U1.4 (LO)
unnamed: D5.1 (K), R9.2
VB1: C2.1, C9.1, D6.1 (K), R9.1, U1.8 (VB)
VS1: C2.2, C9.2, D6.2 (A), J5.2, U1.6 (VS)
