enfoquesolarmx/ISLA_DEL_SOL_PUENTE_H-/hardware/panel/PANEL_LCD_BOTONES.kicad_pcb

## KiCad design hardware/panel/PANEL_LCD_BOTONES.kicad_pcb (2026-11-12)

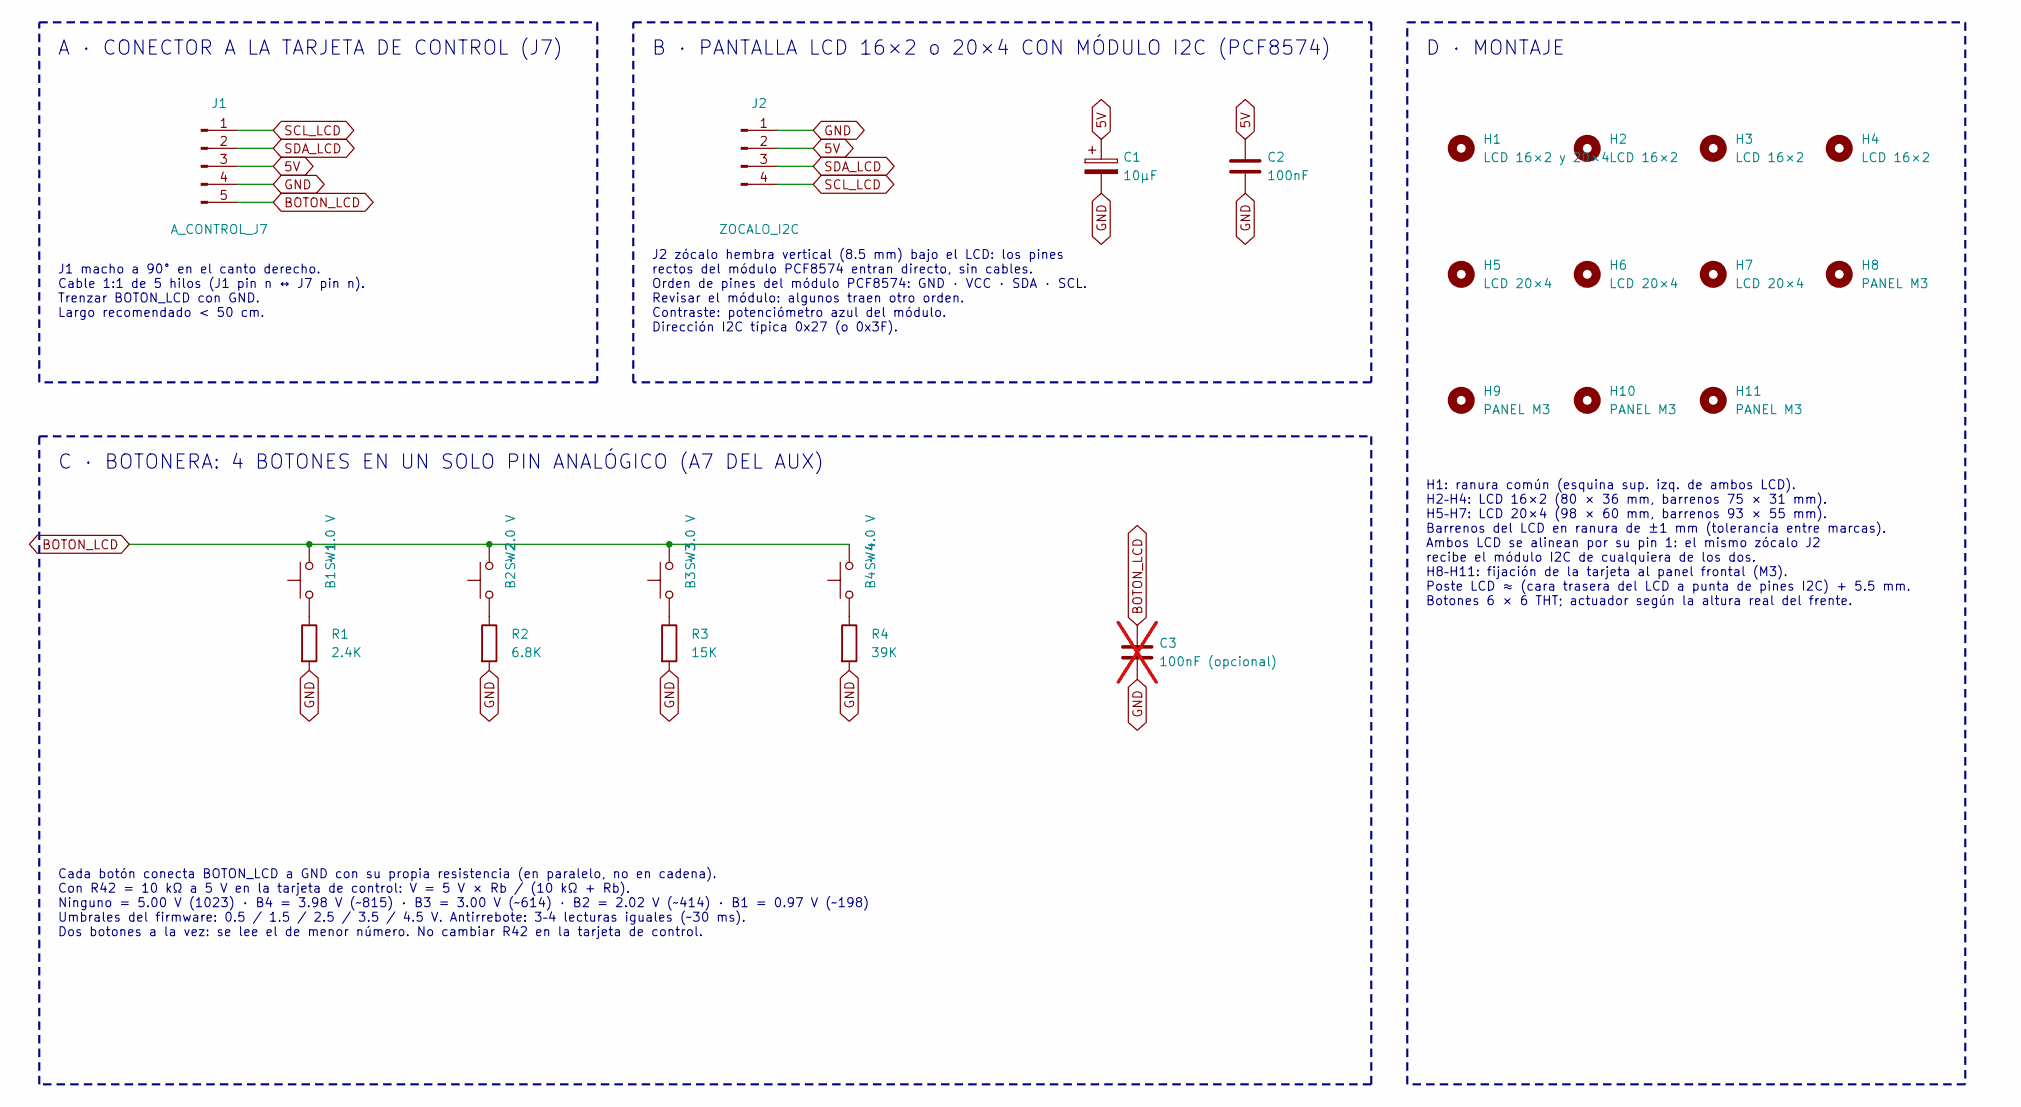
[picture p127: schematic PANEL_LCD_BOTONES.kicad_sch, Isla del Sol — Panel frontal: LCD 16×2 / 20×4 I2C y 4 boton…]

Parts:
C1: 10µF; CP_Radial_D5.0mm_P2.00mm
C2: 100nF; C_Disc_D3.0mm_W2.0mm_P2.50mm
C3: 100nF (opcional); C_Disc_D3.0mm_W2.0mm_P2.50mm; not fitted
H1: LCD 16×2 y 20×4; Ranura_M3_7.2x3.2
H2, H3, H4: LCD 16×2; Ranura_M3_5.2x3.2
H5, H6, H7: LCD 20×4; Ranura_M3_5.2x3.2
H8, H9, H10, H11: PANEL M3; MountingHole_3.2mm_M3
J1: A_CONTROL_J7; PinHeader_1x05_P2.54mm_Horizontal
J2: ZOCALO_I2C; PinSocket_1x04_P2.54mm_Vertical
R1: 2.4K; R_Axial_DIN0204_L3.6mm_D1.6mm_P5.08mm_Horizontal
R2: 6.8K; R_Axial_DIN0204_L3.6mm_D1.6mm_P5.08mm_Horizontal
R3: 15K; R_Axial_DIN0204_L3.6mm_D1.6mm_P5.08mm_Horizontal
R4: 39K; R_Axial_DIN0204_L3.6mm_D1.6mm_P5.08mm_Horizontal
SW1: B1 · 1.0 V; SW_PUSH_6mm_H13mm
SW2: B2 · 2.0 V; SW_PUSH_6mm_H13mm
SW3: B3 · 3.0 V; SW_PUSH_6mm_H13mm
SW4: B4 · 4.0 V; SW_PUSH_6mm_H13mm

Connections:
5V: C1.1, C2.1, J1.3, J2.2
BOTON_LCD: C3.1, J1.5, SW1.2, SW2.2, SW3.2, SW4.2
GND: C1.2, C2.2, C3.2, J1.4, J2.1, R1.2, R2.2, R3.2, R4.2
unnamed: R1.1, SW1.1
unnamed: R2.1, SW2.1
unnamed: R3.1, SW3.1
unnamed: R4.1, SW4.1
SCL_LCD: J1.1, J2.4
SDA_LCD: J1.2, J2.3

Notes on the sheet:
A · CONECTOR A LA TARJETA DE CONTROL (J7)
J1 macho a 90° en el canto derecho. Cable 1:1 de 5 hilos (J1 pin n ↔ J7 pin n). Trenzar BOTON_LCD con GND. Largo recomendado < 50 cm.
B · PANTALLA LCD 16×2 o 20×4 CON MÓDULO I2C (PCF8574)
J2 zócalo hembra vertical (8.5 mm) bajo el LCD: los pines rectos del módulo PCF8574 entran directo, sin cables. Orden de pines del módulo PCF8574: GND · VCC · SDA · SCL. Revisar el módulo: algunos traen otro orden. Contraste: potenciómetro azul del módulo. Dirección I2C típica 0x27 (o 0x3F).
C · BOTONERA: 4 BOTONES EN UN SOLO PIN ANALÓGICO (A7 DEL AUX)
Cada botón conecta BOTON_LCD a GND con su propia resistencia (en paralelo, no en cadena). Con R42 = 10 kΩ a 5 V en la tarjeta de control: V = 5 V × Rb / (10 kΩ + Rb). Ninguno = 5.00 V (1023) · B4 = 3.98 V (~815) · B3 = 3.00 V (~614) · B2 = 2.02 V (~414) · B1 = 0.97 V (~198) Umbrales del firmware: 0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
D · MONTAJE
H1: ranura común (esquina sup. izq. de ambos LCD). H2–H4: LCD 16×2 (80 × 36 mm, barrenos 75 × 31 mm). H5–H7: LCD 20×4 (98 × 60 mm, barrenos 93 × 55 mm). Barrenos del LCD en ranura de ±1 mm (tolerancia entre marcas). Ambos LCD se alinean por su pin 1: el mismo zócalo J2 recibe el módulo I2C de cualq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

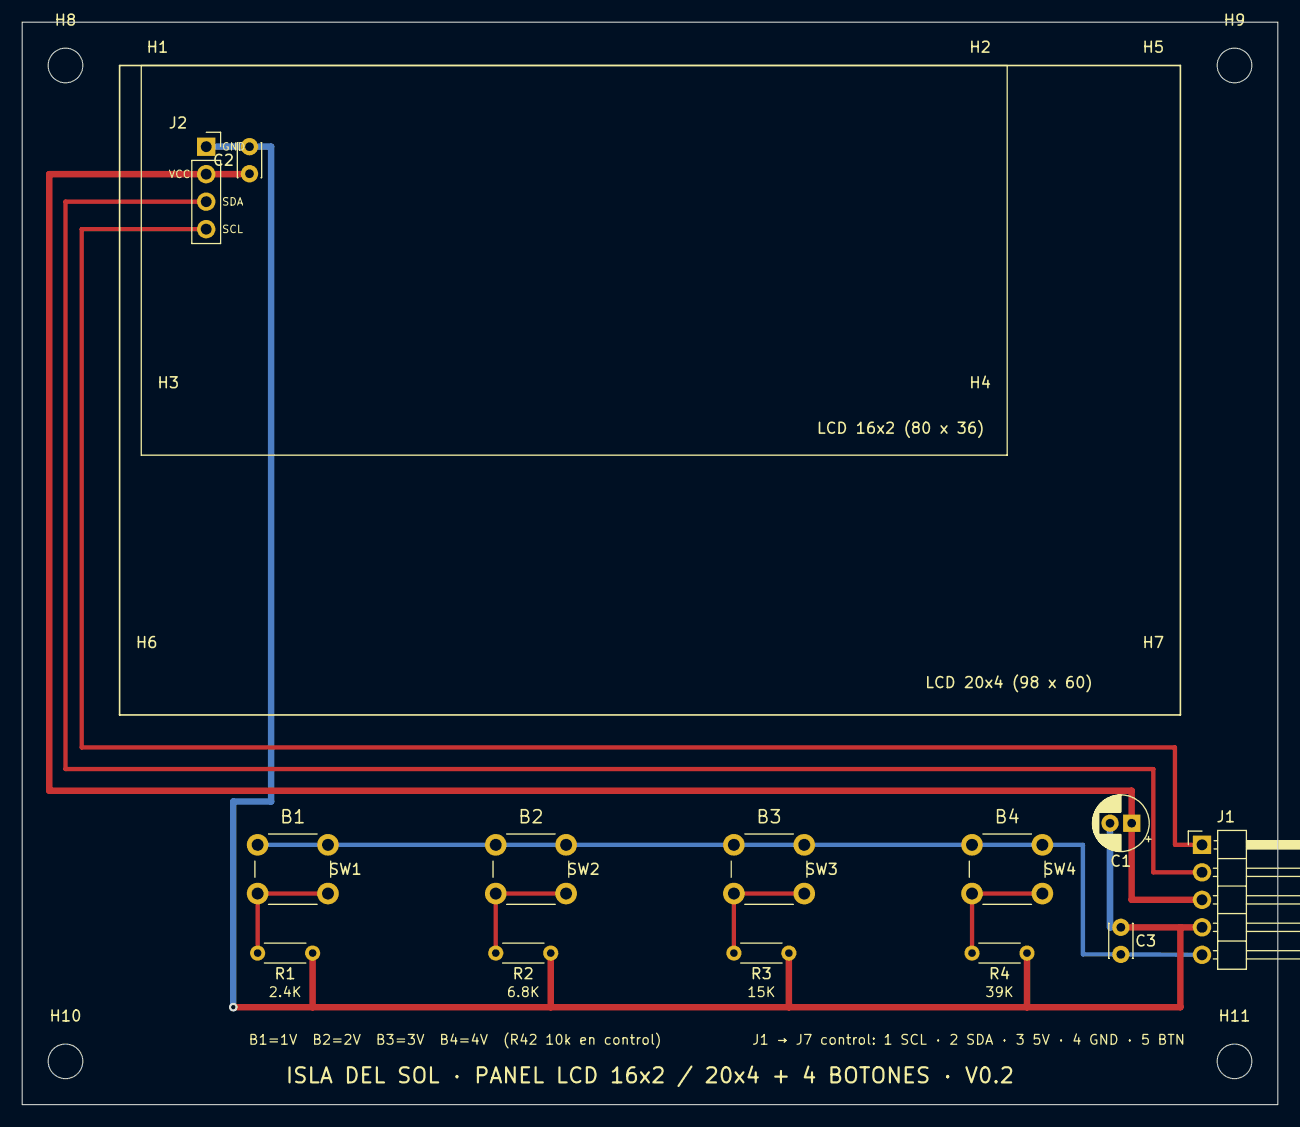
[picture p128: board PANEL_LCD_BOTONES.kicad_pcb from above]

Board: 2 copper layers, 116.0 x 100.0 mm, 24 parts (0 on the bottom side), 9 nets.
