enfoquesolarmx/ISLA_DEL_SOL_PUENTE_H-/hardware/control/ATMEGA328P_SPWM_TARJETA.kicad_pcb

## KiCad design hardware/control/ATMEGA328P_SPWM_TARJETA.kicad_pcb (2026-11-12)

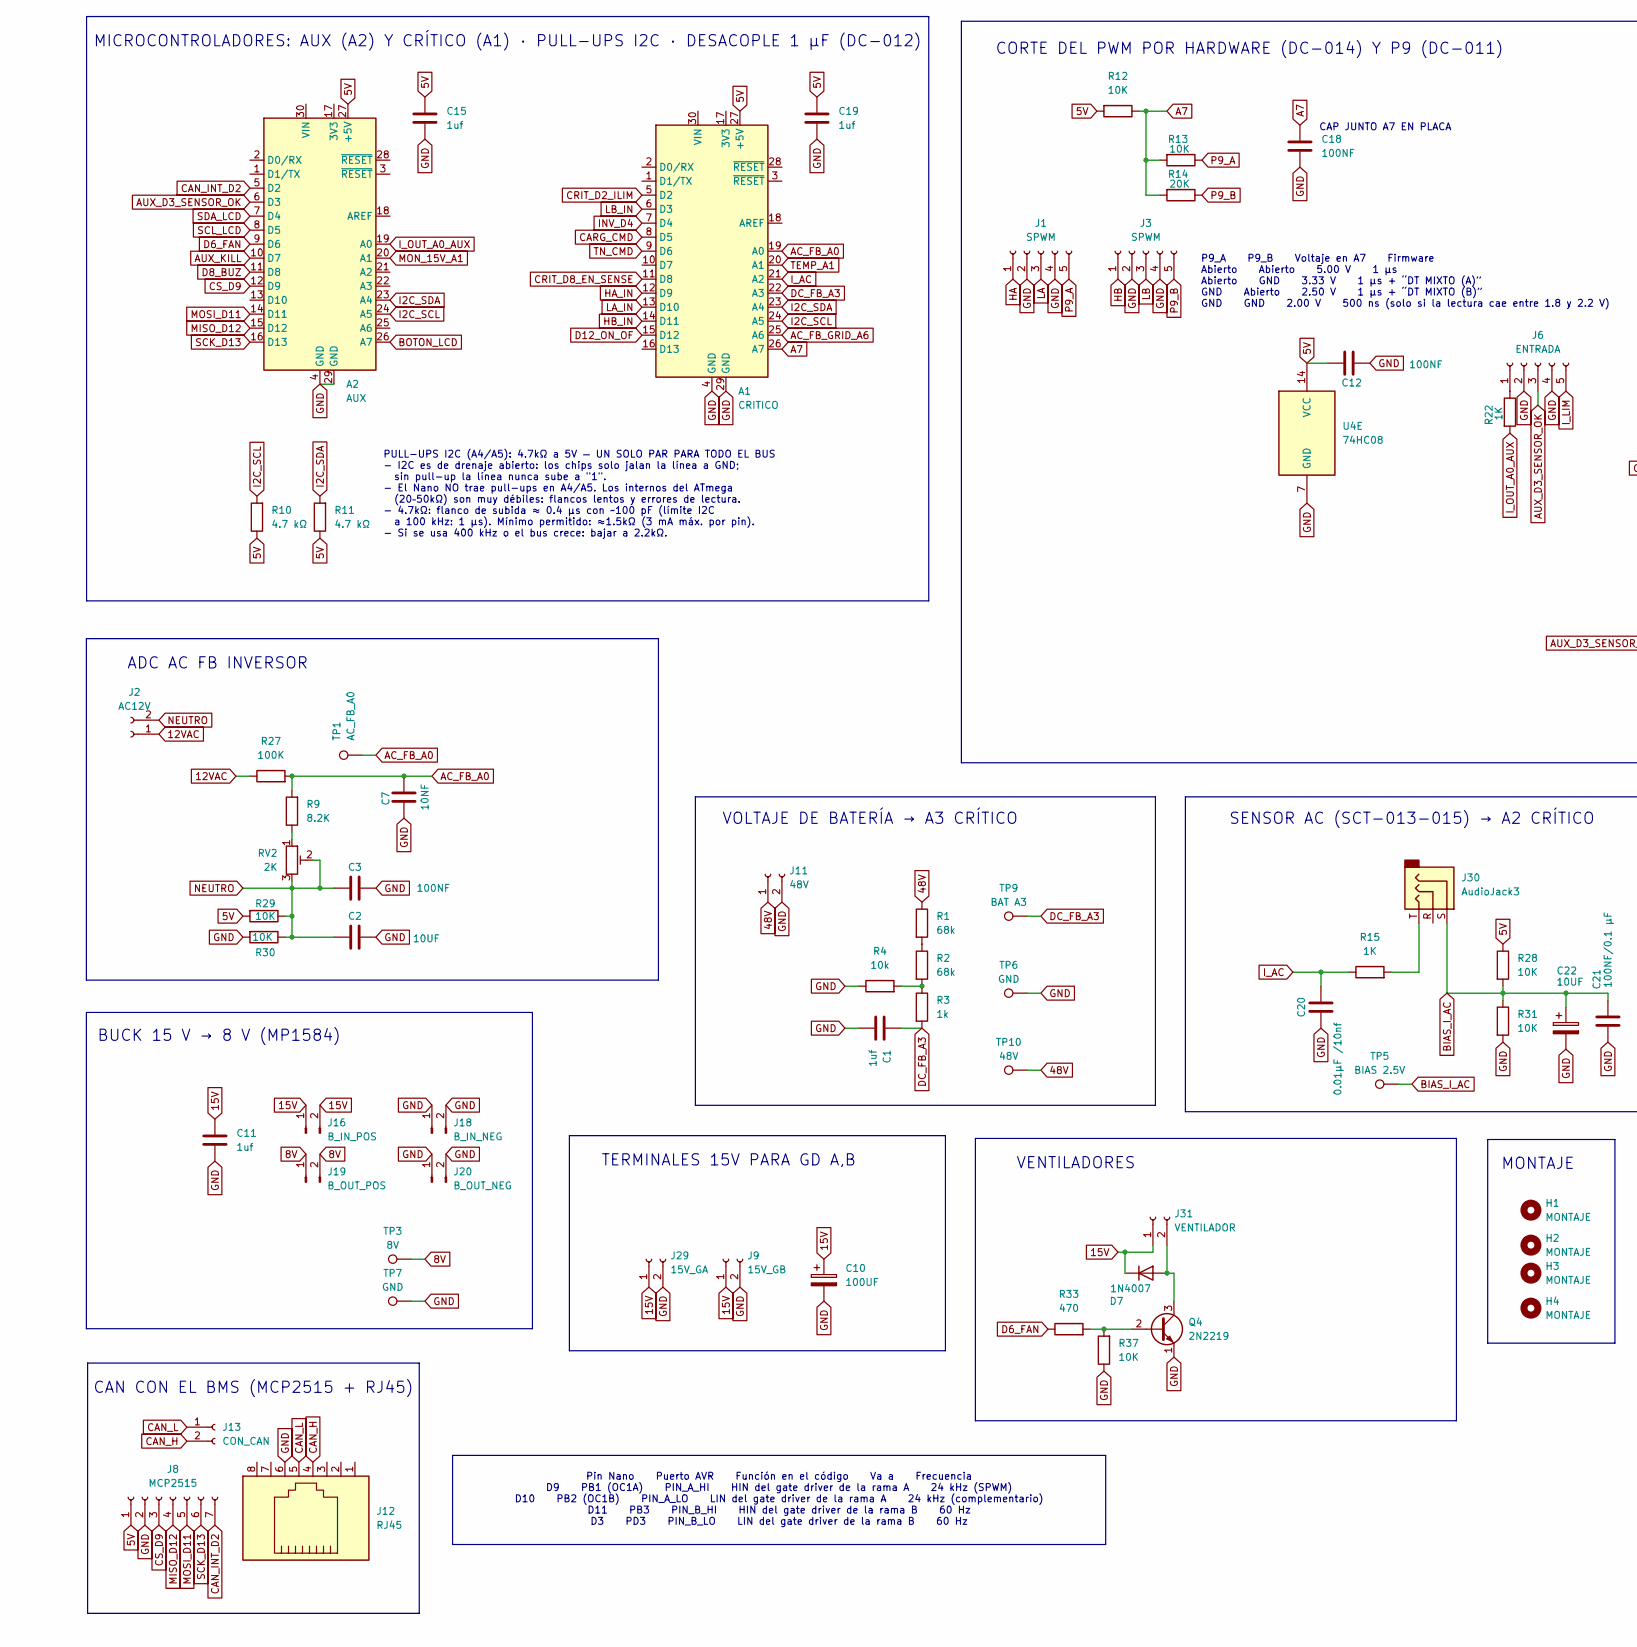
[picture p129: schematic ATMEGA328P_SPWM_TARJETA.kicad_sch, Isla del Sol — Tarjeta de control SPWM (CRÍTICO + AUX), part in row 1, column 1]

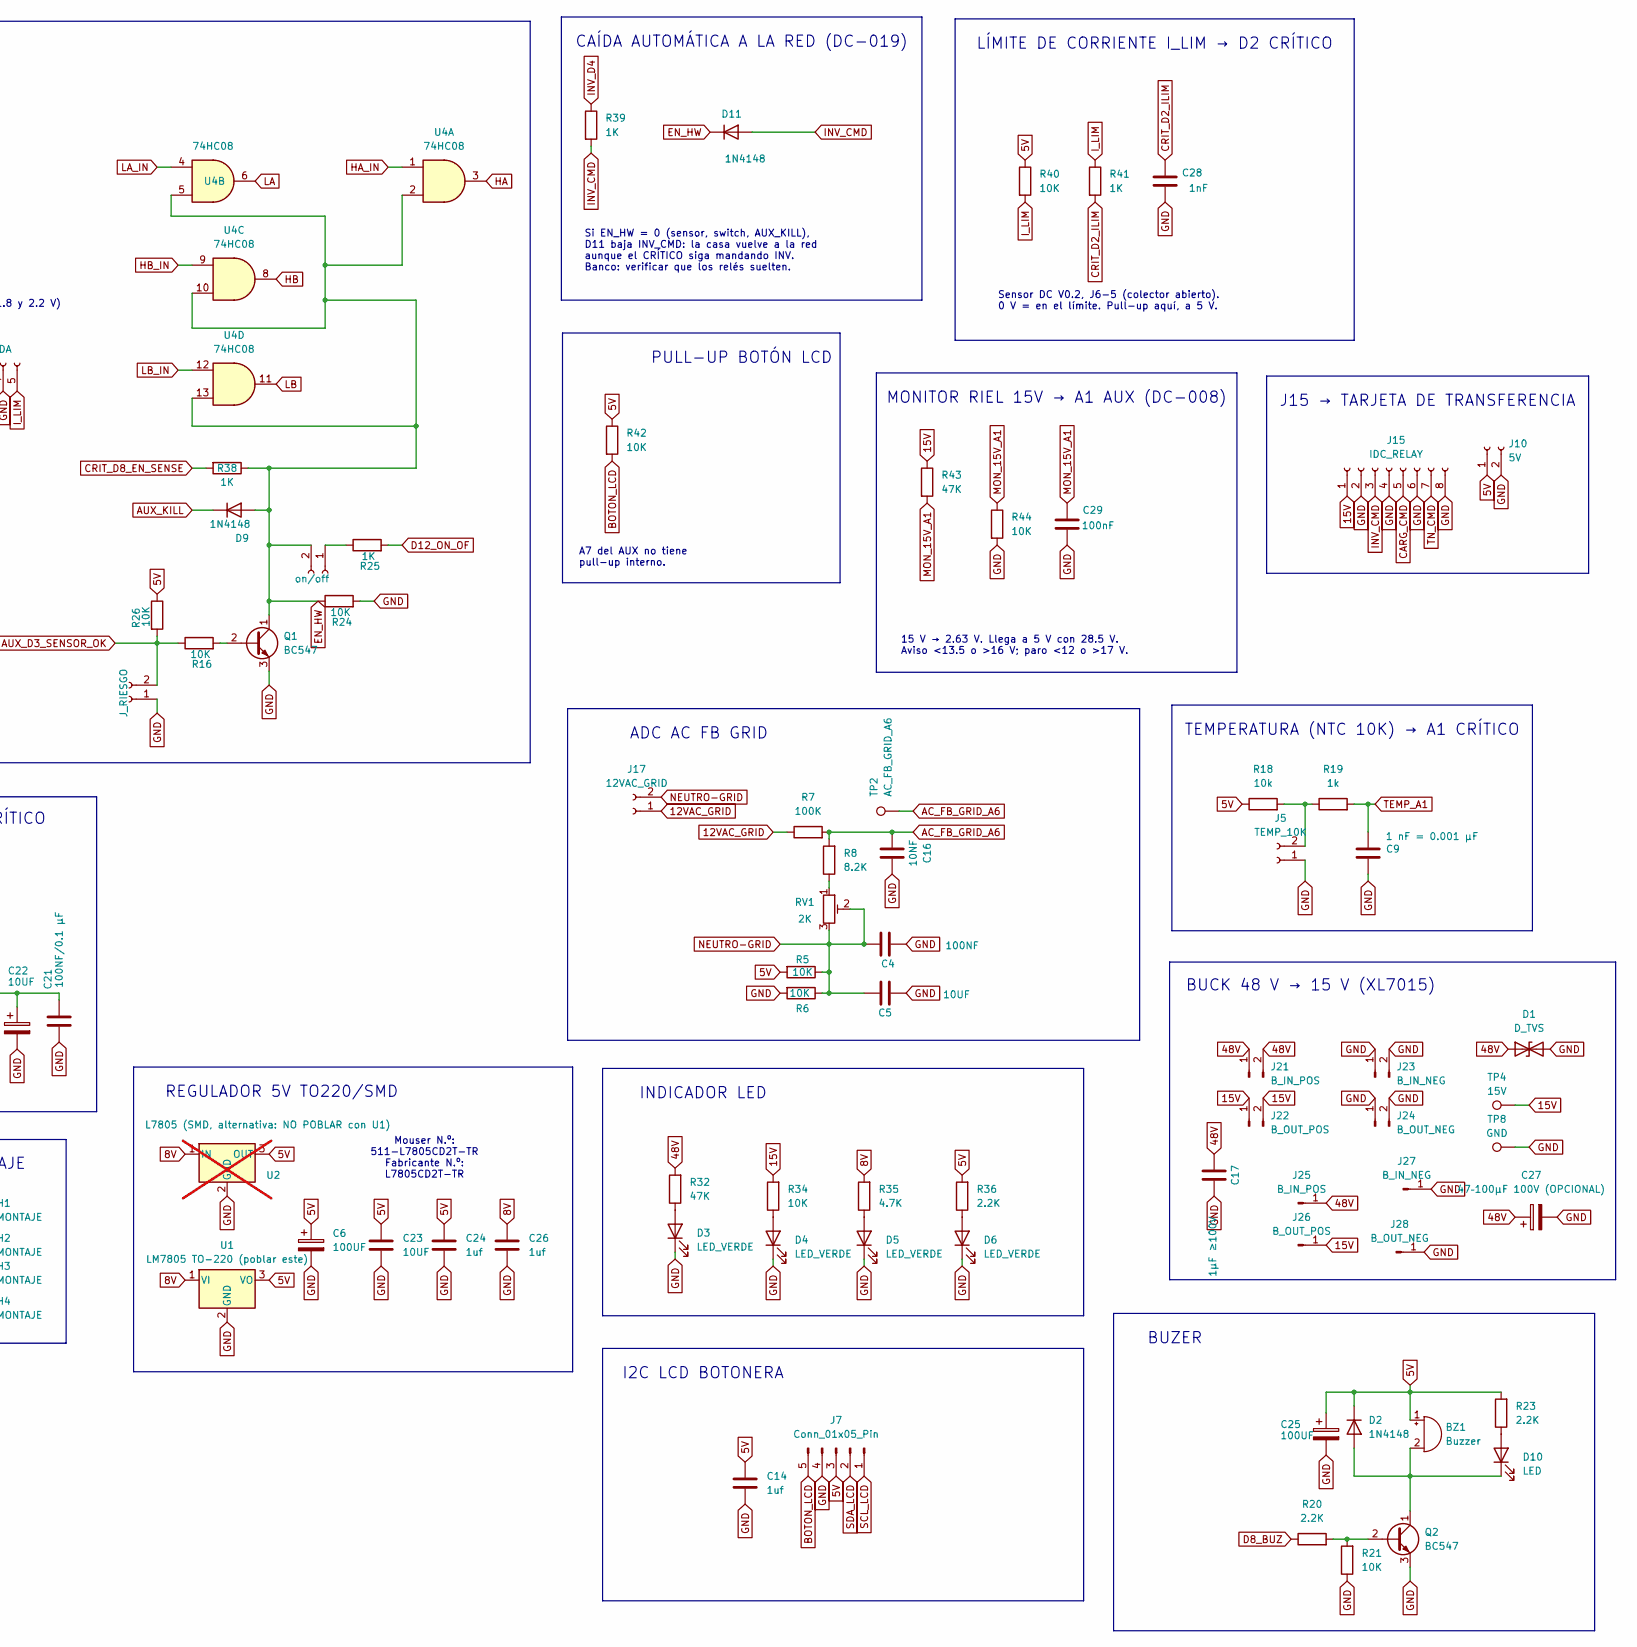
[picture p130: schematic ATMEGA328P_SPWM_TARJETA.kicad_sch, Isla del Sol — Tarjeta de control SPWM (CRÍTICO + AUX), part in row 1, column 2]

Parts:
A1: CRITICO; Arduino_Nano
A2: AUX; Arduino_Nano
BZ1: Buzzer; Buzzer_12x9.5RM7.6
C1, C11, C14, C15, C19, C24, C26: 1uf; C_1206_3216Metric
C2, C5, C23: 10UF; C_1206_3216Metric
C3, C4, C18: 100NF; C_1206_3216Metric
C6, C10: 100UF; CP_Radial_D10.0mm_P5.00mm
C7, C16: 10NF; C_1206_3216Metric
C9: 1 nF = 0.001 µF; C_Disc_D3.0mm_W2.0mm_P2.50mm
C12: 100NF; C_Disc_D3.0mm_W2.0mm_P2.50mm
C17: 1µF ≥100V; C_1210_3225Metric_Pad1.33x2.70mm_HandSolder
C20: 0.01µF /10nf; C_Disc_D3.0mm_W1.6mm_P2.50mm
C21: 100NF/0.1 µF; C_Disc_D3.0mm_W1.6mm_P2.50mm
C22: 10UF; CP_Radial_D8.0mm_P3.50mm
C25: 100UF; CP_Radial_D8.0mm_P3.50mm
C27: 47–100µF 100V (OPCIONAL); CP_Elec_10x10
C28: 1nF; C_Disc_D3.0mm_W2.0mm_P2.50mm
C29: 100nF; C_Disc_D3.0mm_W2.0mm_P2.50mm
D1: D_TVS; D_SMB
D2, D9, D11: 1N4148; D_DO-35_SOD27_P7.62mm_Horizontal
D3, D4, D5, D6: LED_VERDE; LED_1206_3216Metric
D7: 1N4007; D_DO-41_SOD81_P10.16mm_Horizontal
D10: LED; LED_D3.0mm_Clear
H1, H2, H3, H4: MONTAJE; MountingHole_2.7mm_M2.5
J1, J3: SPWM; PhoenixContact_SPT_1.5_5-H-3.5_1x05_P3.5mm_Horizontal
J2: AC12V; TerminalBlock_MaiXu_MX126-5.0-02P_1x02_P5.00mm
J4: on/off; PinHeader_1x02_P2.54mm_Vertical
J5: TEMP_10K; PinHeader_1x02_P2.54mm_Vertical
J6: ENTRADA; PhoenixContact_SPT_1.5_5-H-3.5_1x05_P3.5mm_Horizontal
J7: Conn_01x05_Pin; PinHeader_1x05_P2.54mm_Vertical
J8: MCP2515; PinHeader_1x07_P2.54mm_Vertical
J9: 15V_GB; JST_EH_B2B-EH-A_1x02_P2.50mm_Vertical
J10: 5V; JST_EH_B2B-EH-A_1x02_P2.50mm_Vertical
J11: 48V; TerminalBlock_MaiXu_MX126-5.0-02P_1x02_P5.00mm
J12: RJ45; RJ45_OST_PJ012-8P8CX_Vertical
J13: CON_CAN; PinHeader_1x02_P2.54mm_Vertical
J14: J_RIESGO; PinHeader_1x02_P2.54mm_Vertical
J15: IDC_RELAY; IDC-Header_2x04_P2.54mm_Vertical
J16, J21: B_IN_POS; PinHeader_1x02_P2.54mm_Vertical
J17: 12VAC_GRID; TerminalBlock_MaiXu_MX126-5.0-02P_1x02_P5.00mm
J18, J23: B_IN_NEG; PinHeader_1x02_P2.54mm_Vertical
J19, J22: B_OUT_POS; PinHeader_1x02_P2.54mm_Vertical
J20, J24: B_OUT_NEG; PinHeader_1x02_P2.54mm_Vertical
J25: B_IN_POS; PinHeader_1x01_P2.54mm_Vertical
J26: B_OUT_POS; PinHeader_1x01_P2.54mm_Vertical
J27: B_IN_NEG; PinHeader_1x01_P2.54mm_Vertical
J28: B_OUT_NEG; PinHeader_1x01_P2.54mm_Vertical
J29: 15V_GA; JST_EH_B2B-EH-A_1x02_P2.50mm_Vertical
J30: AudioJack3; Jack_3.5mm_CUI_SJ1-3533NG_Horizontal_CircularHoles
J31: VENTILADOR; JST_EH_B2B-EH-A_1x02_P2.50mm_Vertical
Q1: BC547; TO-92_Inline
Q2: BC547; TO-92_Inline_Wide
Q4: 2N2219; TO-39-3
R1, R2: 68k; R_Axial_DIN0204_L3.6mm_D1.6mm_P5.08mm_Horizontal
R3, R19: 1k; R_Axial_DIN0204_L3.6mm_D1.6mm_P5.08mm_Horizontal
R4, R18: 10k; R_Axial_DIN0204_L3.6mm_D1.6mm_P5.08mm_Horizontal
R5, R6, R12, R13, R16, R21, R24, R26, R28, R29, R30, R31, R34, R37, R40, R42, R44: 10K; R_Axial_DIN0204_L3.6mm_D1.6mm_P5.08mm_Horizontal
R7, R27: 100K; R_Axial_DIN0204_L3.6mm_D1.6mm_P5.08mm_Horizontal
R8, R9: 8.2K; R_Axial_DIN0204_L3.6mm_D1.6mm_P5.08mm_Horizontal
R10, R11: 4.7 kΩ; R_Axial_DIN0204_L3.6mm_D1.6mm_P5.08mm_Horizontal
R14: 20K; R_Axial_DIN0204_L3.6mm_D1.6mm_P5.08mm_Horizontal
R15, R22, R25, R38, R39, R41: 1K; R_Axial_DIN0204_L3.6mm_D1.6mm_P5.08mm_Horizontal
R20, R23, R36: 2.2K; R_Axial_DIN0204_L3.6mm_D1.6mm_P5.08mm_Horizontal
R32, R43: 47K; R_Axial_DIN0204_L3.6mm_D1.6mm_P5.08mm_Horizontal
R33: 470; R_Axial_DIN0204_L3.6mm_D1.6mm_P5.08mm_Horizontal
R35: 4.7K; R_Axial_DIN0204_L3.6mm_D1.6mm_P5.08mm_Horizontal
RV1, RV2: 2K; Potentiometer_Bourns_3296W_Vertical
TP1: AC_FB_A0; TestPoint_Loop_D2.50mm_Drill1.0mm_LowProfile
TP2: AC_FB_GRID_A6; TestPoint_Loop_D2.50mm_Drill1.0mm_LowProfile
TP3: 8V; TestPoint_Loop_D2.50mm_Drill1.0mm_LowProfile
TP4: 15V; TestPoint_Loop_D2.50mm_Drill1.0mm_LowProfile
TP5: BIAS 2.5V; TestPoint_Loop_D2.50mm_Drill1.0mm_LowProfile
TP6, TP7, TP8: GND; TestPoint_Loop_D2.50mm_Drill1.0mm_LowProfile
TP9: BAT A3; TestPoint_Loop_D2.50mm_Drill1.0mm_LowProfile
TP10: 48V; TestPoint_Loop_D2.50mm_Drill1.0mm_LowProfile
U1: LM7805 TO-220 (poblar este); TO-220-3_Horizontal_TabDown
U2: L7805 (SMD, alternativa: NO POBLAR con U1); TO-252-2; not fitted
U4: 74HC08; DIP-14_W7.62mm_Socket

Connections:
5V: A1.27 (+5V), A2.27 (+5V), BZ1.1 (+), C6.1, C12.1, C14.1, C15.1, C19.1, C23.1, C24.1, C25.1, D2.1 (K), J7.3, J8.1, J10.1, R5.2, R10.1, R11.1, R12.2, R18.1, R23.2, R26.1, R28.1, R29.2, R36.2, R40.1, R42.1, U1.3 (VO), U2.3 (OUT), U4.14 (VCC)
8V: C26.1, J19.1, J19.2, R35.2, TP3.1, U1.1 (VI), U2.1 (IN)
12VAC: J2.1, R27.1
12VAC_GRID: J17.1, R7.1
15V: C10.1, C11.1, D7.1 (K), J9.1, J15.1, J16.1, J16.2, J22.1, J22.2, J26.1, J29.1, J31.1, R34.2, R43.1, TP4.1
48V: C17.1, C27.1, D1.1 (A1), J11.1, J21.1, J21.2, J25.1, R1.1, R32.2, TP10.1
A7: A1.26 (A7), C18.1, R12.1, R13.2, R14.2
AC_FB_A0: A1.19 (A0), C7.1, R9.2, R27.2, TP1.1
AC_FB_GRID_A6: A1.25 (A6), C16.1, R7.2, R8.2, TP2.1
AUX_D3_SENSOR_OK: A2.6 (D3), J6.3, J14.2, R16.1, R26.2
AUX_KILL: A2.10 (D7), D9.1 (K)
BIAS_I_AC: C21.1, C22.1, J30.S, R28.2, R31.1, TP5.1
BOTON_LCD: A2.26 (A7), J7.5, R42.2
CAN_H: J12.4, J13.2
CAN_INT_D2: A2.5 (D2), J8.7
CAN_L: J12.5, J13.1
CARG_CMD: A1.8 (D5), J15.5
CRIT_D2_ILIM: A1.5 (D2), C28.1, R41.2
CRIT_D8_EN_SENSE: A1.11 (D8), R38.2
CS_D9: A2.12 (D9), J8.3
D6_FAN: A2.9 (D6), R33.1
D8_BUZ: A2.11 (D8), R20.1
D12_ON_OF: A1.15 (D12), R25.2
DC_FB_A3: A1.22 (A3), C1.1, R3.2, TP9.1
EN_HW: D9.2 (A), D11.1 (K), J4.2, Q1.1 (C), R24.1, R38.1, U4.2, U4.5, U4.10, U4.13
GND: A1.4 (GND), A1.29 (GND), A2.4 (GND), A2.29 (GND), C1.2, C2.2, C3.2, C4.2, C5.2, C6.2, C7.2, C9.2, C10.2, C11.2, C12.2, C14.2, C15.2, C16.2, C17.2, C18.2, C19.2, C20.2, C21.2, C22.2, C23.2, C24.2, C25.2, C26.2, C27.2, C28.2, C29.2, D1.2 (A2), D3.1 (K), D4.1 (K), D5.1 (K), D6.1 (K), J1.2, J1.4, J3.2, J3.4, J5.1, J6.2, J6.4, J7.4, J8.2, J9.2, J10.2, J11.2, J12.6, J14.1, J15.2, J15.4, J15.6, J15.8, J18.1, J18.2, J20.1, J20.2, J23.1, J23.2, J24.1, J24.2, J27.1, J28.1, J29.2, Q1.3 (E), Q2.3 (E), Q4.1 (E), R4.1, R6.2, R21.1, R24.2, R30.2, R31.2, R37.1, R44.2, TP6.1, TP7.1, TP8.1, U1.2 (GND), U2.2 (GND), U4.7 (GND)
HA: J1.1, U4.3
HA_IN: A1.12 (D9), U4.1
HB: J3.1, U4.8
HB_IN: A1.14 (D11), U4.9
I2C_SCL: A1.24 (A5), A2.24 (A5), R10.2
I2C_SDA: A1.23 (A4), A2.23 (A4), R11.2
INV_CMD: D11.2 (A), J15.3, R39.2
INV_D4: A1.7 (D4), R39.1
I_AC: A1.21 (A2), C20.1, R15.1
I_LIM: J6.5, R40.2, R41.1
I_OUT_A0_AUX: A2.19 (A0), R22.2
LA: J1.3, U4.6
LA_IN: A1.13 (D10), U4.4
LB: J3.3, U4.11
LB_IN: A1.6 (D3), U4.12
MISO_D12: A2.15 (D12), J8.4
MON_15V_A1: A2.20 (A1), C29.1, R43.2, R44.1
MOSI_D11: A2.14 (D11), J8.5
NEUTRO: C2.1, C3.1, J2.2, R29.1, R30.1, RV2.2, RV2.3
NEUTRO-GRID: C4.1, C5.1, J17.2, R5.1, R6.1, RV1.2, RV1.3
unnamed: BZ1.2 (-), D2.2 (A), D10.1 (K), Q2.1 (C)
unnamed: D3.2 (A), R32.1
unnamed: D4.2 (A), R34.1
unnamed: D5.2 (A), R35.1
unnamed: D6.2 (A), R36.1
unnamed: D7.2 (A), J31.2, Q4.3 (C)
unnamed: D10.2 (A), R23.1
unnamed: J4.1, R25.1
unnamed: J5.2, R18.2, R19.1
unnamed: J6.1, R22.1
unnamed: J30.T, R15.2
unnamed: Q1.2 (B), R16.2
unnamed: Q2.2 (B), R20.2, R21.2
unnamed: Q4.2 (B), R33.2, R37.2
unnamed: R1.2, R2.1
unnamed: R2.2, R3.1, R4.2
unnamed: R8.1, RV1.1
unnamed: R9.1, RV2.1
P9_A: J1.5, R13.1
P9_B: J3.5, R14.1
SCK_D13: A2.16 (D13), J8.6
SCL_LCD: A2.8 (D5), J7.1
SDA_LCD: A2.7 (D4), J7.2
TEMP_A1: A1.20 (A1), C9.1, R19.2
TN_CMD: A1.9 (D6), J15.7

Notes on the sheet:
MONTAJE
TERMINALES 15V PARA GD A,B
Mouser N.º: 511-L7805CD2T-TR Fabricante N.º: L7805CD2T-TR
BUZER
P9_A P9_B Voltaje en A7 Firmware Abierto Abierto 5.00 V 1 µs Abierto GND 3.33 V 1 µs + “DT MIXTO (A)” GND Abierto 2.50 V 1 µs + “DT MIXTO (B)” GND GND 2.00 V 500 ns (solo si la lectura cae entre 1.8 y 2.2 V)
MONITOR RIEL 15V → A1 AUX (DC-008)
REGULADOR 5V TO220/SMD
PULL-UP BOTÓN LCD
BUCK 15 V → 8 V (MP1584)
ADC AC FB GRID
MICROCONTROLADORES: AUX (A2) Y CRÍTICO (A1) · PULL-UPS I2C · DESACOPLE 1 µF (DC-012)
CAÍDA AUTOMÁTICA A LA RED (DC-019)
CORTE DEL PWM POR HARDWARE (DC-014) Y P9 (DC-011)
CAN CON EL BMS (MCP2515 + RJ45)
BUCK 48 V → 15 V (XL7015)
J15 → TARJETA DE TRANSFERENCIA
VOLTAJE DE BATERÍA → A3 CRÍTICO
Si EN_HW = 0 (sensor, switch, AUX_KILL), D11 baja INV_CMD: la casa vuelve a la red aunque el CRÍTICO siga mandando INV. Banco: verificar que los relés suelten.
VENTILADORES
PULL-UPS I2C (A4/A5): 4.7kΩ a 5V — UN SOLO PAR PARA TODO EL BUS - I2C es de drenaje abierto: los chips solo jalan la línea a GND; sin pull-up la línea nunca sube a "1". - El Nano NO trae pull-ups en A4/A5. Los internos del ATmega (20–50kΩ) son muy débiles: flancos lentos y errores de lectura. - 4.7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
CAP JUNTO A7 EN PLACA
Sensor DC V0.2, J6-5 (colector abierto). 0 V = en el límite. Pull-up aquí, a 5 V.
SENSOR AC (SCT-013-015) → A2 CRÍTICO
A7 del AUX no tiene pull-up interno.
I2C LCD BOTONERA
ADC AC FB INVERSOR
LÍMITE DE CORRIENTE I_LIM → D2 CRÍTICO
Pin Nano Puerto AVR Función en el código Va a Frecuencia D9 PB1 (OC1A) PIN_A_HI HIN del gate driver de la rama A 24 kHz (SPWM) D10 PB2 (OC1B) PIN_A_LO LIN del gate driver de la rama A 24 kHz (complementario) D11 PB3 PIN_B_HI HIN del gate driver de la rama B 60 Hz D3 PD3 PIN_B_LO LIN del gate driver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
15 V → 2.63 V. Llega a 5 V con 28.5 V. Aviso <13.5 o >16 V; paro <12 o >17 V.
TEMPERATURA (NTC 10K) → A1 CRÍTICO
INDICADOR LED

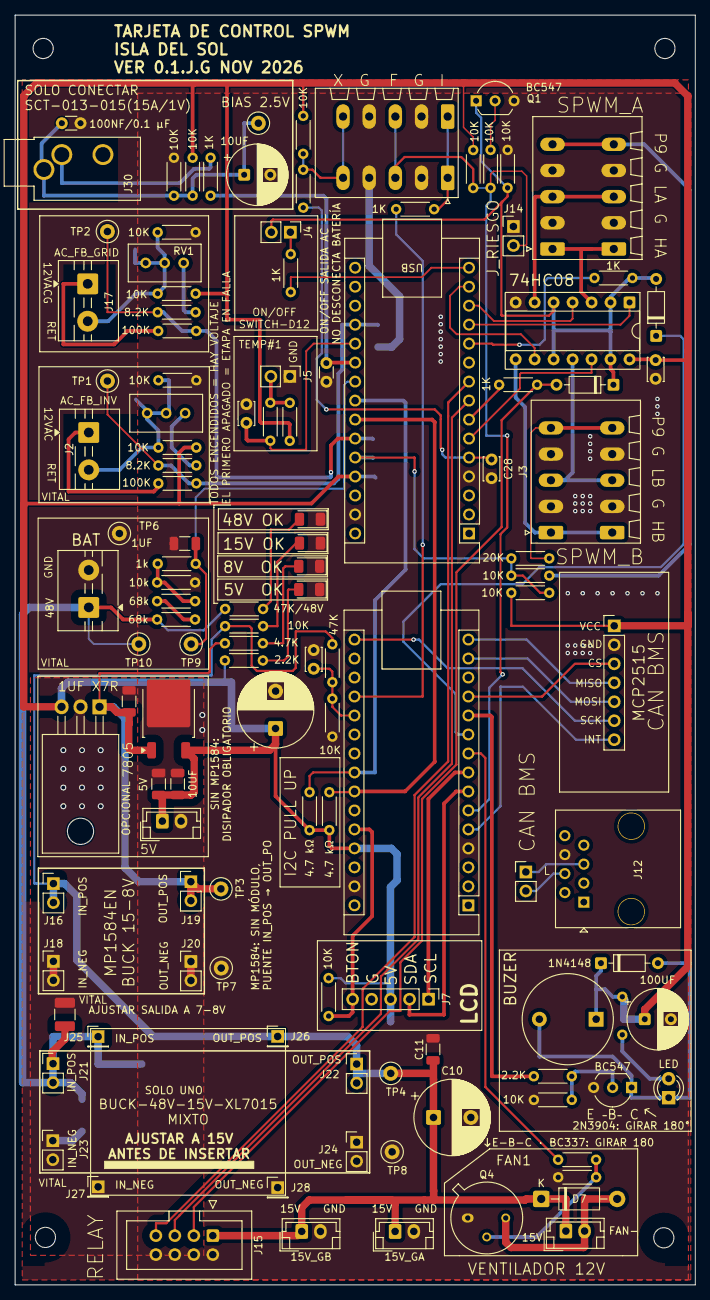
[picture p131: board ATMEGA328P_SPWM_TARJETA.kicad_pcb from above]

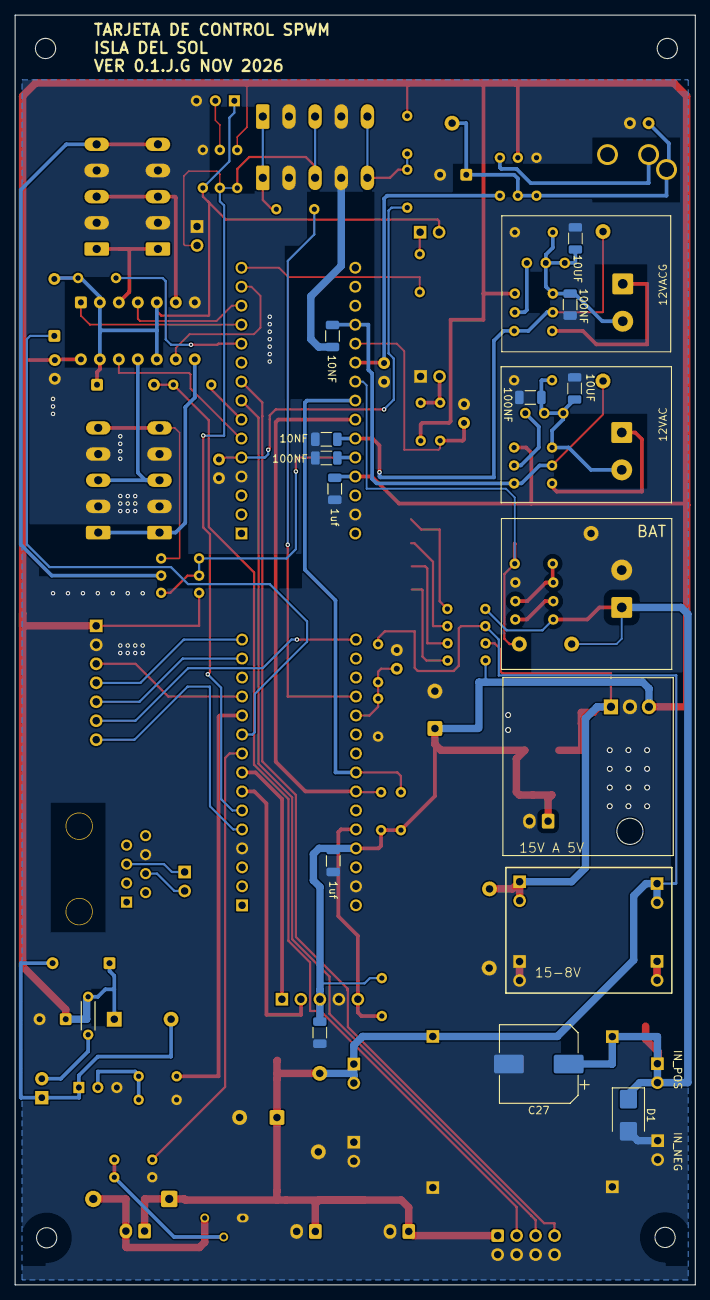
[picture p132: board ATMEGA328P_SPWM_TARJETA.kicad_pcb from below]

Board: 2 copper layers, 91.0 x 169.9 mm, 136 parts (13 on the bottom side), 71 nets.
