enfoquesolarmx/ISLA_DEL_SOL_PUENTE_H-/hardware/transferencia_reles/RELAY_TRANSFER_INV_RED.kicad_pcb

## KiCad design hardware/transferencia_reles/RELAY_TRANSFER_INV_RED.kicad_pcb (2026-11-11)

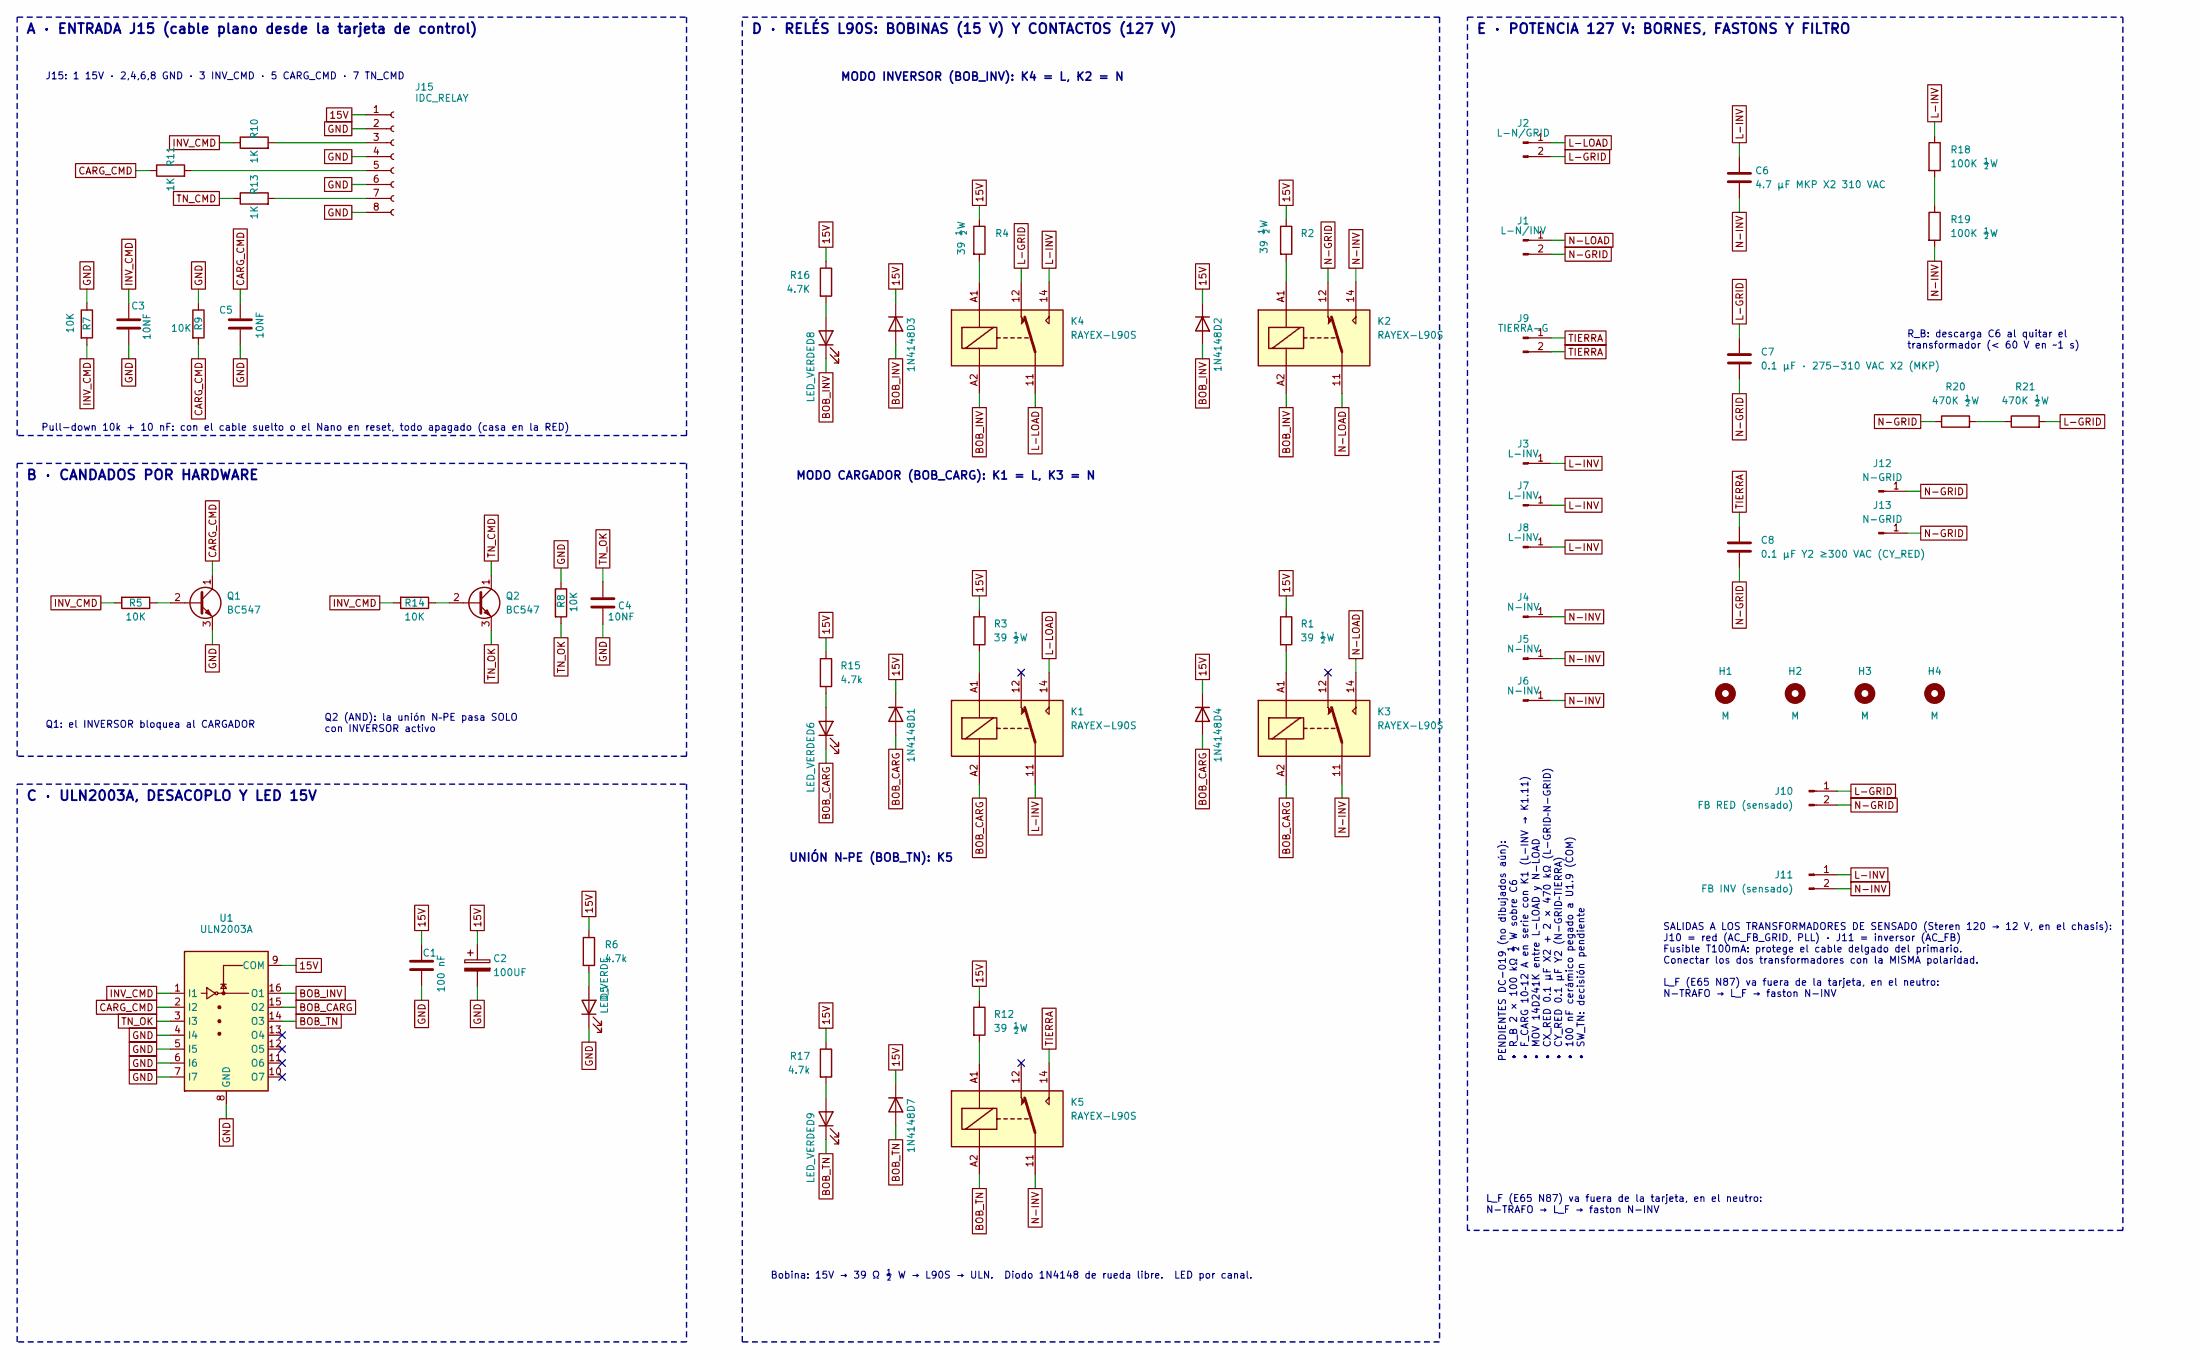
[picture p133: schematic RELAY_TRANSFER_INV_RED.kicad_sch, Isla del Sol — Tarjeta de transferencia de carga (red / inv…]

Parts:
C1: 100 nF; C_Disc_D3.0mm_W1.6mm_P2.50mm
C2: 100UF; CP_Radial_D10.0mm_P3.50mm
C3, C4, C5: 10NF; C_Disc_D3.0mm_W1.6mm_P2.50mm
C6: 4.7 µF MKP X2 310 VAC; C_Rect_L31.5mm_W20.0mm_P27.50mm_MKS4
C7: 0.1 µF · 275-310 VAC X2 (MKP); C_Rect_L18.0mm_W6.0mm_P15.00mm_FKS3_FKP3
C8: 0.1 µF Y2 ≥300 VAC (CY_RED); C_Rect_L26.5mm_W8.5mm_P22.50mm_MKS4
D1, D2, D3, D4, D7: 1N4148; D_DO-35_SOD27_P7.62mm_Horizontal
D5, D6, D8, D9: LED_VERDE; LED_D3.0mm
H1, H2, H3, H4: M; MountingHole_4.3mm_M4
J1: L-N/INV; PhoenixContact_SPT_2.5_2-V-5.0-EX_1x02_P5.0mm_Vertical
J2: L-N/GRID; PhoenixContact_SPT_2.5_2-V-5.0-EX_1x02_P5.0mm_Vertical
J3, J8: L-INV; SolderWire-2.5sqmm_1x01_D2.4mm_OD3.6mm_Relief
J4: N-INV; Faston 63823
J5, J6: N-INV; SolderWire-2.5sqmm_1x01_D2.4mm_OD3.6mm_Relief
J7: L-INV; Faston 63823
J9: TIERRA-G; PhoenixContact_SPT_2.5_2-V-5.0-EX_1x02_P5.0mm_Vertical
J10: FB RED (sensado); PhoenixContact_SPT_2.5_2-V-5.0-EX_1x02_P5.0mm_Vertical
J11: FB INV (sensado); PhoenixContact_SPT_2.5_2-V-5.0-EX_1x02_P5.0mm_Vertical
J12, J13: N-GRID; SolderWire-2.5sqmm_1x01_D2.4mm_OD3.6mm
J15: IDC_RELAY; IDC-Header_2x04_P2.54mm_Vertical
K1, K2, K3, K4, K5: RAYEX-L90S; Relay_SPDT_RAYEX-L90S
Q1, Q2: BC547; TO-92_Inline_Wide
R1, R2, R3, R4, R12: 39 ½W; R_Axial_DIN0207_L6.3mm_D2.5mm_P10.16mm_Horizontal
R5, R7, R8, R9, R14: 10K; R_Axial_DIN0204_L3.6mm_D1.6mm_P5.08mm_Horizontal
R6, R15, R17: 4.7k; R_Axial_DIN0204_L3.6mm_D1.6mm_P5.08mm_Horizontal
R10, R11, R13: 1K; R_Axial_DIN0204_L3.6mm_D1.6mm_P5.08mm_Horizontal
R16: 4.7K; R_Axial_DIN0204_L3.6mm_D1.6mm_P5.08mm_Horizontal
R18, R19: 100K ½W; R_Axial_DIN0207_L6.3mm_D2.5mm_P10.16mm_Horizontal
R20, R21: 470K ½W; R_Axial_DIN0207_L6.3mm_D2.5mm_P10.16mm_Horizontal
U1: ULN2003A; DIP-16_W7.62mm

Connections:
15V: C1.2, C2.1, D1.1 (K), D2.1 (K), D3.1 (K), D4.1 (K), D7.1 (K), J15.1, R1.1, R2.1, R3.1, R4.1, R6.1, R12.1, R15.1, R16.1, R17.1, U1.9 (COM)
BOB_CARG: D1.2 (A), D4.2 (A), D6.1 (K), K1.A2, K3.A2, U1.15 (O2)
BOB_INV: D2.2 (A), D3.2 (A), D8.1 (K), K2.A2, K4.A2, U1.16 (O1)
BOB_TN: D7.2 (A), D9.1 (K), K5.A2, U1.14 (O3)
CARG_CMD: C5.2, Q1.1 (C), R9.2, R11.1, U1.2 (I2)
GND: C1.1, C2.2, C3.1, C4.1, C5.1, D5.1 (K), J15.2, J15.4, J15.6, J15.8, Q1.3 (E), R7.1, R8.1, R9.1, U1.4 (I4), U1.5 (I5), U1.6 (I6), U1.7 (I7), U1.8 (GND)
INV_CMD: C3.2, R5.2, R7.2, R10.1, R14.2, U1.1 (I1)
L-GRID: C7.1, J2.2, J10.1, K4.12, R21.2
L-INV: C6.1, J3.1, J7.1, J8.1, J11.1, K1.11, K4.14, R18.1
L-LOAD: J2.1, K1.14, K4.11
N-GRID: C7.2, C8.2, J1.2, J10.2, J12.1, J13.1, K2.12, R20.1
N-INV: C6.2, J4.1, J5.1, J6.1, J11.2, K2.14, K3.11, K5.11, R19.2
N-LOAD: J1.1, K2.11, K3.14
unnamed: D5.2 (A), R6.2
unnamed: D6.2 (A), R15.2
unnamed: D8.2 (A), R16.2
unnamed: D9.2 (A), R17.2
unnamed: J15.3, R10.2
unnamed: J15.5, R11.2
unnamed: J15.7, R13.2
unnamed: K1.A1, R3.2
unnamed: K2.A1, R2.2
unnamed: K3.A1, R1.2
unnamed: K4.A1, R4.2
unnamed: K5.A1, R12.2
unnamed: Q1.2 (B), R5.1
unnamed: Q2.2 (B), R14.1
unnamed: R18.2, R19.1
unnamed: R20.2, R21.1
TIERRA: C8.1, J9.1, J9.2, K5.14
TN_CMD: Q2.1 (C), R13.1
TN_OK: C4.2, Q2.3 (E), R8.2, U1.3 (I3)

Notes on the sheet:
B · CANDADOS POR HARDWARE
E · POTENCIA 127 V: BORNES, FASTONS Y FILTRO
Q1: el INVERSOR bloquea al CARGADOR
Pull-down 10k + 10 nF: con el cable suelto o el Nano en reset, todo apagado (casa en la RED)
J15: 1 15V · 2,4,6,8 GND · 3 INV_CMD · 5 CARG_CMD · 7 TN_CMD
Bobina: 15V → 39 Ω ½ W → L90S → ULN. Diodo 1N4148 de rueda libre. LED por canal.
R_B: descarga C6 al quitar el transformador (< 60 V en ~1 s)
D · RELÉS L90S: BOBINAS (15 V) Y CONTACTOS (127 V)
UNIÓN N–PE (BOB_TN): K5
Q2 (AND): la unión N–PE pasa SOLO con INVERSOR activo
C · ULN2003A, DESACOPLO Y LED 15V
SALIDAS A LOS TRANSFORMADORES DE SENSADO (Steren 120 → 12 V, en el chasis): J10 = red (AC_FB_GRID, PLL) · J11 = inversor (AC_FB) Fusible T100mA: protege el cable delgado del primario. Conectar los dos transformadores con la MISMA polaridad.
MODO CARGADOR (BOB_CARG): K1 = L, K3 = N
MODO INVERSOR (BOB_INV): K4 = L, K2 = N
L_F (E65 N87) va fuera de la tarjeta, en el neutro: N-TRAFO → L_F → faston N-INV
PENDIENTES DC-019 (no dibujados aún): • R_B 2 × 100 kΩ ½ W sobre C6 • F_CARG 10–12 A en serie con K1 (L-INV → K1.11) • MOV 14D241K entre L-LOAD y N-LOAD • CX_RED 0.1 µF X2 + 2 × 470 kΩ (L-GRID–N-GRID) • CY_RED 0.1 µF Y2 (N-GRID–TIERRA) • 100 nF cerámico pegado a U1.9 (COM) • SW_TN: decisión pendien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
A · ENTRADA J15 (cable plano desde la tarjeta de control)
