enfoquesolarmx/ISLA_DEL_SOL_PUENTE_H-/hardware/transferencia_reles/RELAY_TRANSFER_INV_RED.kicad_pcb

## KiCad design hardware/transferencia_reles/RELAY_TRANSFER_INV_RED.kicad_pcb (continued)

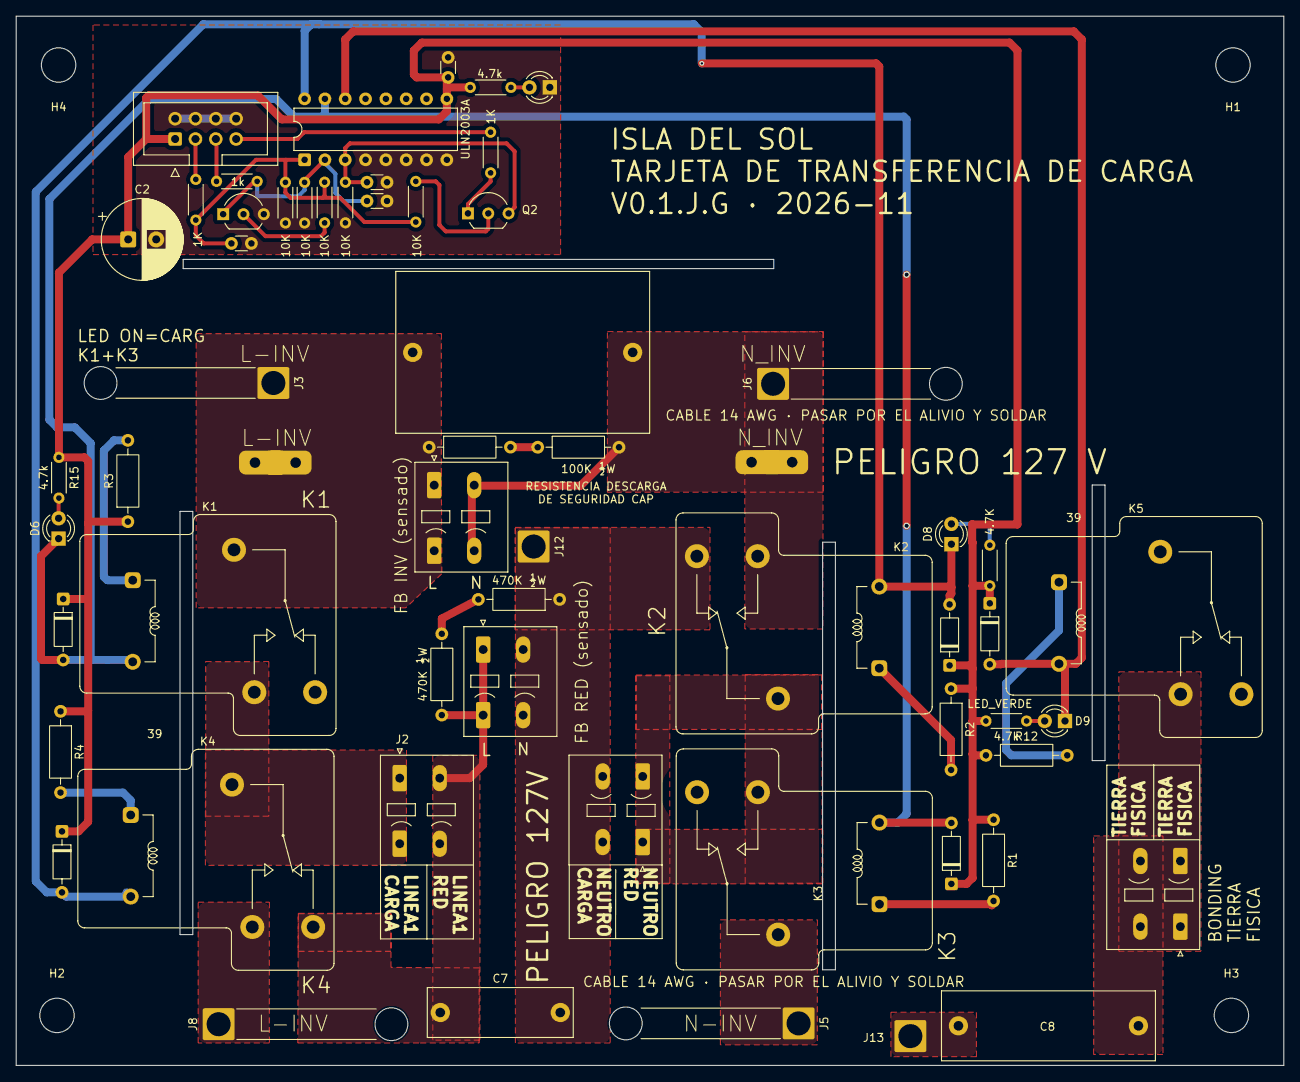
[picture p134: board RELAY_TRANSFER_INV_RED.kicad_pcb from above]

Board: 2 copper layers, 158.4 x 131.1 mm, 64 parts (0 on the bottom side), 32 nets.
