enfoquesolarmx/ISLA_DEL_SOL_PUENTE_H-/hardware/sensores/sensor-dc-ina-comparador/SENSOR_DC_INA_COMPARADOR_V2.kicad_pcb

## KiCad design hardware/sensores/sensor-dc-ina-comparador/SENSOR_DC_INA_COMPARADOR_V2.kicad_pcb (2026-11-08)

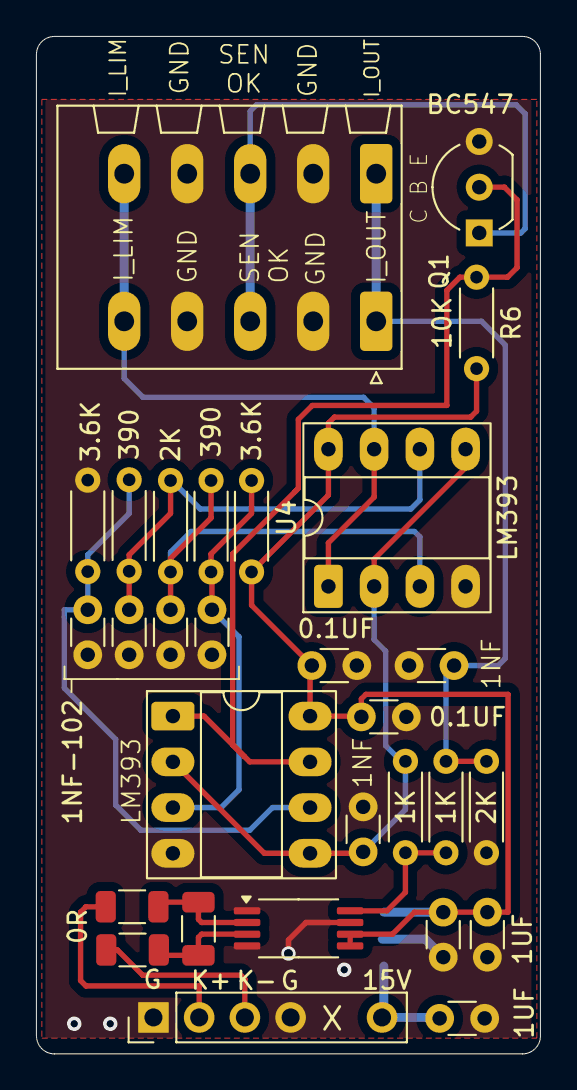
[picture p135: board SENSOR_DC_INA_COMPARADOR_V2.kicad_pcb from above]

Board: 2 copper layers, 28.0 x 56.5 mm, 30 parts (1 on the bottom side), 17 nets.

Parts:
C1: 0.01UF; C_Disc_D3.0mm_W1.6mm_P2.50mm
C2, C5, C6: 0.1UF; C_Disc_D3.0mm_W1.6mm_P2.50mm
C3: 0.01UF; C_1206_3216Metric
C4, C7, C8, C9, C10: 0.001UF/1NF-102; C_Disc_D3.0mm_W1.6mm_P2.50mm
C14, C15: 1UF; C_Disc_D3.0mm_W1.6mm_P2.50mm
J1: INPUT_INA; PinHeader_1x06_P2.54mm_Vertical
J2: SALIDA; PhoenixContact_SPT_1.5_5-H-3.5_1x05_P3.5mm_Horizontal
Q1: BC547; TO-92_Inline_Wide
R1, R8: 1K; R_Axial_DIN0204_L3.6mm_D1.6mm_P5.08mm_Horizontal
R2, R10: 2K; R_Axial_DIN0204_L3.6mm_D1.6mm_P5.08mm_Horizontal
R3, R4: 0; R_1206_3216Metric
R5, R7: 3.6K; R_Axial_DIN0204_L3.6mm_D1.6mm_P5.08mm_Horizontal
R6: 10K; R_Axial_DIN0204_L3.6mm_D1.6mm_P5.08mm_Horizontal
R9, R11: 390; R_Axial_DIN0204_L3.6mm_D1.6mm_P5.08mm_Horizontal
U1: L78L05_SOT89; SOT-89-3
U2: INA240A1PW; TSSOP-8_4.4x3mm_P0.65mm
U3, U4: LM393; DIP-8_W7.62mm_Socket_LongPads

Connections:
5V: C2.1, C5.1, C6.1, C14.1, R5.2, R6.2, U1.1 (OUT), U2.5 (V+), U2.6 (REF2), U3.8 (V+), U4.8 (V+)
15V: C15.1, J1.6, U1.3 (IN)
FAULT: Q1.2 (B), R6.1, U3.1, U3.7
GND: C1.2, C2.2, C4.2, C5.2, C6.2, C7.1, C8.1, C9.1, C10.1, C14.2, C15.2, J1.1, J1.4, J2.2, J2.4, Q1.3 (E), R2.1, R7.1, U1.2 (GND), U2.1 (GND), U2.4 (GND), U2.7 (REF1), U3.4 (V-), U4.4 (V-)
IN+ (Kelvin): J1.2, R3.1
IN- (Kelvin): J1.3, R4.1
INA_OUT: R1.1, R8.1, U2.8
INA_RC: C4.1, R8.2, U3.2 (-), U3.5 (+), U4.2 (-), U4.5 (+)
I_LIM: J2.5, U4.1, U4.7
I_OUT: C1.1, J2.1, R1.2, R2.2
unnamed: C3.1, R3.2, U2.2 (+)
unnamed: C3.2, R4.2, U2.3 (-)
SENSOR_OK: J2.3, Q1.1 (C)
V_ALTO: C7.2, R5.1, R9.2, U3.3 (+)
V_BAJO: C10.2, R7.2, R11.1, U3.6 (-)
V_LIM_ALTO: C8.2, R9.1, R10.2, U4.3 (+)
V_LIM_BAJO: C9.2, R10.1, R11.2, U4.6 (-)
