enfoquesolarmx/ISLA_DEL_SOL_PUENTE_H-/firmware/critico/ISLA_CRITICO/tabla_seno.h

/*
 * =============================================================================
 *  tabla_seno.h  -  Isla del Sol, micro CRÍTICO (A1)
 *  ARCHIVO GENERADO por herramientas/genera_tabla_seno.py: no editar a mano.
 * -----------------------------------------------------------------------------
 *  Dos tablas de un cuarto de onda de seno (0° a 90°), una por frecuencia de
 *  línea, con la portadora fija de 24000 Hz.
 *  Q16: 65535 = 1.0. Cada muestra tomada al CENTRO de su periodo de portadora,
 *  para que el espejo (muestra k = muestra S-1 - k) sea exacto.
 *  Ocupan 440 B de flash y 0 B de RAM (PROGMEM).
 *  Por qué así: ver "MUESTRAS DE LA TABLA SENO" en config_portadora.h.
 *
 *  Licencia: MIT (ver LICENSE.md del repositorio).
 * =============================================================================
 */
#pragma once
#include <stdint.h>
#include <avr/pgmspace.h>
#include "config_portadora.h"

// 60 Hz: 400 muestras por ciclo, 200 por semiciclo, 100 guardadas.
//   tabla[k] = round( 65535 × sen( (k + 0.5) × 180° / 200 ) ),  k = 0 .. 99
static_assert(MUESTRAS_CUARTO_60 == 100,
  "tabla_seno.h no corresponde a la portadora: vuelva a correr genera_tabla_seno.py");
const uint16_t TABLA_SENO_60_Q16[100] PROGMEM = {
    515,  1544,  2573,  3601,  4629,  5655,  6680,  7703,  8724,  9743,   // k =   0..  9  ( 0.45° ...)
  10760, 11774, 12785, 13793, 14798, 15799, 16796, 17789, 18777, 19761,   // k =  10.. 19  ( 9.45° ...)
  20740, 21714, 22683, 23646, 24603, 25554, 26499, 27437, 28368, 29293,   // k =  20.. 29  (18.45° ...)
  30210, 31120, 32022, 32916, 33802, 34680, 35549, 36409, 37261, 38103,   // k =  30.. 39  (27.45° ...)
  38936, 39759, 40572, 41376, 42169, 42952, 43724, 44485, 45236, 45975,   // k =  40.. 49  (36.45° ...)
  46703, 47419, 48124, 48817, 49497, 50166, 50822, 51466, 52097, 52715,   // k =  50.. 59  (45.45° ...)
  53320, 53912, 54490, 55056, 55607, 56145, 56669, 57179, 57675, 58157,   // k =  60.. 69  (54.45° ...)
  58624, 59077, 59515, 59939, 60348, 60742, 61120, 61484, 61833, 62167,   // k =  70.. 79  (63.45° ...)
  62485, 62787, 63075, 63346, 63602, 63842, 64067, 64276, 64469, 64646,   // k =  80.. 89  (72.45° ...)
  64807, 64952, 65081, 65194, 65291, 65371, 65436, 65484, 65517, 65533,   // k =  90.. 99  (81.45° ...)
};

// 50 Hz: 480 muestras por ciclo, 240 por semiciclo, 120 guardadas.
//   tabla[k] = round( 65535 × sen( (k + 0.5) × 180° / 240 ) ),  k = 0 .. 119
static_assert(MUESTRAS_CUARTO_50 == 120,
  "tabla_seno.h no corresponde a la portadora: vuelva a correr genera_tabla_seno.py");
const uint16_t TABLA_SENO_50_Q16[120] PROGMEM = {
    429,  1287,  2144,  3001,  3858,  4714,  5569,  6424,  7277,  8129,   // k =   0..  9  ( 0.38° ...)
   8979,  9828, 10675, 11521, 12364, 13206, 14045, 14881, 15716, 16547,   // k =  10.. 19  ( 7.88° ...)
  17376, 18201, 19024, 19843, 20659, 21471, 22280, 23085, 23886, 24682,   // k =  20.. 29  (15.38° ...)
  25475, 26263, 27047, 27826, 28600, 29369, 30134, 30893, 31647, 32395,   // k =  30.. 39  (22.88° ...)
  33138, 33875, 34607, 35332, 36052, 36765, 37472, 38173, 38867, 39554,   // k =  40.. 49  (30.38° ...)
  40235, 40908, 41575, 42235, 42887, 43532, 44169, 44799, 45421, 46036,   // k =  50.. 59  (37.88° ...)
  46643, 47241, 47832, 48414, 48988, 49554, 50111, 50659, 51199, 51730,   // k =  60.. 69  (45.38° ...)
  52252, 52766, 53270, 53765, 54251, 54727, 55195, 55652, 56101, 56539,   // k =  70.. 79  (52.88° ...)
  56968, 57387, 57797, 58196, 58586, 58965, 59334, 59693, 60042, 60381,   // k =  80.. 89  (60.38° ...)
  60709, 61027, 61335, 61632, 61918, 62194, 62459, 62713, 62957, 63190,   // k =  90.. 99  (67.88° ...)
  63412, 63623, 63823, 64012, 64191, 64358, 64514, 64660, 64794, 64917,   // k = 100..109  (75.38° ...)
  65029, 65130, 65219, 65298, 65365, 65421, 65466, 65500, 65522, 65534,   // k = 110..119  (82.88° ...)
};
