enfoquesolarmx/ISLA_DEL_SOL_PUENTE_H-/(commit log)

2026-11-07 docs: bitácora de decisiones críticas y líneas nuevas de la visión
    - docs/decisiones_criticas.md (nuevo): DC-001 a DC-009 — cascada de
    alimentación 48→15→8→5 V, XL7015 en socket mixto, protección de la
    entrada de 48 V, MP1584, 7805, sensado AC y de batería, tablero de
    diagnóstico con LED y valores de referencia, holgura para capacidad
    médica (objetivo a futuro).
    - docs/vision_isla_del_sol.md: línea política (sección 5.1) y principio
    "entre más información se transfiere, más se estabiliza el sistema"
    (sección 7) con enlace a la bitácora.
    - README.md: árbol y tabla de documentos.
    Claude-Session: http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
2026-11-07 docs: DC-010 reparto de tareas entre ATmega, enlace I2C con latido y CAN para el BMS
    Claude-Session: https://claude.ai/code/session_01QeVmKMzSdVA89kmdzuChhd
2026-11-07 docs: DC-011 lectura de P9, un pin por rama
    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
2026-11-07 docs: DC-011 actualizado a lectura de P9 en un solo pin analógico (A7)
    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
2026-11-07 docs: DC-012 los Nano se alimentan por +5V (pin 27), nunca por VIN
    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
2026-11-07 docs: DC-013 corriente AC con SCT-013-015 en el CRÍTICO (A2)
    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
2026-11-07 docs: DC-008 LED a ~1.3 mA, 47 kΩ en 48 V
    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
2026-11-08 docs: corte del PWM por hardware (SENSOR_OK, EN_HW, 74HC08) y DC-014
    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
2026-11-08 docs: DC-015 corriente de fuga y aislamiento diferidas a la V2; DC-009 actualizado
    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
2026-11-08 docs: DC-016 corto circuito en AC (niveles, motor contra corto contra arco, transferencia, reintentos)
    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
2026-11-08 docs: DC-016 huellas de corto, arco y motor; energía del arco; chispa e incendio; inconsistencia de umbrales
    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
2026-11-08 docs: DC-017 presupuesto de CPU y memoria; alternativa Nano Every (ATmega4809) en el mismo socket
    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
2026-11-08 docs: DC-018 cargador híbrido a 24 kHz y socket multimodelo 328P/4809 (20 MHz); nota en modulación SPWM
    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
2026-11-08 hardware: módulo sensor DC V0.2 (SENSOR_OK con Q1, U4 límite ±75 A, I_LIM en J2-5); DC-016 resuelto
    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
2026-11-08 hardware: README sensor DC V0.2 con diagrama LM393 y evidencia del proceso
    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
2026-11-08 README: módulo sensor DC V0.2
    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
2026-11-08 hardware: archivos de KiCad del módulo sensor DC V0.2 (reemplazan la V0.1)
    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
    [SENSOR_DC_INA_COMPARADOR.kicad_pcb, SENSOR_DC_INA_COMPARADOR_V2.kicad_pcb, SENSOR_DC_INA_COMPARADOR_V2.kicad_sch]
2026-11-09 docs: DC-019 con el capacitor del filtro de salida (C_F MKP X2) en la entrada del transformador
    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
2026-11-09 docs: estudio de referencia OutBack FX (neutro común, tierra de chasis, unión N–PE manual)
    - docs/referencia_outback_fx.md: piezas, mediciones de banco, arquitectura,
    base normativa NOM-001-SEDE-2012 250-24/250-30, guía de 4 casos de
    instalación, comparación con la V1 y pendientes M7–M11.
    - Diagrama docs/img/referencia_outback_fx.png (+ script) y 4 fotos.
    - DC-019: anexo de referencia industrial y referencia [25].
    - README: fila en la tabla de documentos.
    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
2026-11-09 docs(fx): sección 8.1, modo de operación configurable en el SETUP (UPS / fuente principal)
    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
2026-11-09 DC-019: modos INVERSOR CASA (con unión N–PE) e INVERSOR CARGA (UPS, sin unión)
    - Punto 10: selector SW_TN DPDT (polo A en la bobina de RL_TN, polo B
    MODO_TN por J15-8 al CRÍTICO D4), verificación contra el menú del SETUP,
    valor de fábrica CARGA, requisitos de instalación de cada modo.
    - J15-8 pasa de GND a MODO_TN; tabla de estados, falla de RL_TN y regla
    de firmware de coincidencia.
    - Diagrama de transferencia con SW_TN-A/B y J15-8.
    - Estudio FX, sección 8.1 y tabla comparativa alineadas.
    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
2026-11-09 README: contenido del repositorio con el estudio FX, carpetas img y bitácora DC-001 a DC-019; índice de docs/img
    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
2026-11-09 DC-019: LED 15V junto al ULN2003 y un LED por relé; diagnóstico del cable J15
    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
2026-11-09 DC-019: RL_TN en canal propio (TN desde AUX D10) con Q2 como AND por hardware; se elimina PC817/PRES_CARGA
    - Diagrama: Q2 BC547 seguidor de emisor (TN pasa solo con AISLAR activo),
    I3 → O3 (14) → SW_TN-A → RL_TN; J15-7 = TN (AUX D10); sin PC817.
    - Todos los relés L90S con 39 Ω; referencias KiCad (K4, K2, K1, K3, K5).
    - Texto: tabla de canales, J15, consecuencias de quitar la autoprueba
    y mitigaciones, análisis de falla y reglas de firmware.
    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
2026-11-09 Diagrama DC-019: Q2 dibujado como NPN horizontal (C ← TN, B ← AISLAR, E → I3) para evitar confusión con PNP
    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
2026-11-10 DC-019: inductor de filtro L_F (E65 N87) en el neutro, antes de C_F; R_D+C_D como huella opcional
    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
2026-11-10 Estudio FX: arquitectura real (Deltrol 3P ∥ red + Zettler 2P ∥ transformador), filtro EMI CX/CY, sensado Hall y R1–R8 (M7–M14) con fotos; DC-019 8c: CX_RED, descarga y CY_RED
    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
2026-11-11 Tarjeta de transferencia de carga V0.1 (hardware/transferencia_reles)
    - Proyecto KiCad 9 (esquemático y PCB verificados pin por pin), reglas
    de separación .kicad_dru (5 mm potencia–lógica, 3 mm entre redes de
    potencia) y modelo 3D aproximado del relé T90 / L90S (STEP + script).
    - README: por qué la Isla del Sol necesita la tarjeta, modos, candados
    Q1/Q2, unión N–PE automática según el SETUP, conectores, filtro y
    descarga, layout, separaciones medidas, consumo, ensamble, pruebas,
    BOM, diferencias con DC-019 y bitácora.
    - Auditoría térmica a 10 A (red, inversor, cargador): el cobre de 1 oz
    basta; relés de 15 V sin resistencia en serie.
    - DC-019: actualizados los pun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
    [RELAY_TRANSFER_INV_RED.kicad_pcb, RELAY_TRANSFER_INV_RED.kicad_sch, Relay_SPDT_RAYEX-L90S_aprox.step]
2026-11-12 Lenguaje internacional (sin CFE ni Nano genérico) y enlaces a la tarjeta de transferencia
    - CFE → "red eléctrica pública" / "acometida de la red eléctrica" en
    DC-019, el estudio del OutBack FX y el diagrama de DC-019.
    - "el Nano" genérico → "el microcontrolador" en decisiones críticas y en
    el corte por hardware (y su diagrama). Se conserva "Arduino Nano" /
    "Nano Every" donde se habla de la tarjeta física (pines, USB, socket).
    - Diagramas regenerados: esquematico_transferencia_v1_dc019.png y
    esquematico_corte_completo.png.
    - README principal: render 3D de la tarjeta de transferencia bajo el del
    puente H, enlace directo al proyecto en su tabla y estado V0.1 en la
    tabla d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
2026-11-12 Tarjeta de control SPWM V0.1 (hardware/control) con glosario de módulos
    - KiCad 9: esquemático reacomodado por bloques (A2) y PCB. Esquemático =
    PCB verificado pin por pin, conectividad completa, separaciones >= 0.2 mm,
    DRC sin errores.
    - Cambios V0.1: J15 con nombres INV_CMD / CARG_CMD / TN_CMD (D4/D5/D6 del
    CRÍTICO); caída automática a la red (R39 + D11 a EN_HW); I_LIM a D2
    (R40, R41, C28); pull-up de la botonera (R42); monitor del riel de 15 V
    en A1 del AUX (R43, R44, C29); U2 sin poblar; J31 = VENTILADOR.
    - README: glosario de los 22 módulos con qué hace y por qué cada
    componente, LCD 16x2 con 4 botones, layout, vistas 3D y pendientes.
    - DC-019: asignación real de J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
    [ATMEGA328P_SPWM_TARJETA.kicad_pcb, ATMEGA328P_SPWM_TARJETA.kicad_sch]
2026-11-12 Control V0.1: pendiente de render solo en perspectiva
    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
2026-11-12 Panel frontal V0.2: LCD 16x2 / 20x4 I2C y 4 botones (hardware/panel)
    - Esquemático y PCB KiCad 9 (116 x 100 mm, 2 capas), cable 1:1 a J7 de control
    - Módulo PCF8574 directo a zócalo hembra J2; ranuras M3 de ±1 mm para ambos LCD
    - README: datos que muestra, propuesta de pantallas y menú SETUP (CASA / UPS),
    montaje, verificación antes de fabricar, ensamble y BOM
    - Enlaces desde el README principal y el módulo 18 de la tarjeta de control
    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
    [PANEL_LCD_BOTONES.kicad_pcb, PANEL_LCD_BOTONES.kicad_sch]
2026-11-12 IRS2186: esquemático por bloques A–F y README al circuito real
    - Esquemático reordenado (A entrada, B 15 V, C driver, D bootstrap, E salida,
    F firmware y compras) con notas de diseño; conexiones idénticas (comparadas pin por pin)
    - J2 -> J1, 1SMA5931B1 -> D6, red D5-K -> VB1 (también en el PCB)
    - D5 con símbolo de diodo rápido; valores con voltaje y dieléctrico;
    J5-3/J5-8 sin conexión; PWR_FLAG en 15V y GND para el ERC
    - README: R9 va después de D5 (15 V -> D5 -> R9 -> VB1), imagen del esquemático y bitácora
    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
    [GATE_DRIVER_IRS2186.kicad_pcb, GATE_DRIVER_IRS2186.kicad_sch]
2026-11-12 IR2110 + tótem: esquemático por bloques con guía de trinchera
    - Esquemático A3 en bloques A–I (entrada, 5 V, driver, 15 V, bootstrap,
    tótem alto, tótem bajo, salida, guía rápida); conexiones idénticas (pin por pin)
    - Z1/Z2 (antes 1SMA5931B1/B2), redes VB1, HO_IR, LO_IR; D5 como diodo rápido;
    valores con voltaje y dieléctrico; NC en J2-5, J5-3/8/9; PWR_FLAG para el ERC
    - PCB: referencias, redes y valores sincronizados (sin mover pistas)
    - README: imagen, sección 0 "Guía rápida de trinchera" (cuidados y prueba sin MOSFET)
    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
    [GATE_DRIVER_IR2110_TOTEM.kicad_pcb, GATE_DRIVER_IR2110_TOTEM.kicad_sch]
2026-11-12 IR2110: esquemático y PCB actualizados por el autor (F8 aplicado; se quitó un tramo suelto de P9); imagen del esquemático
    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
    [GATE_DRIVER_IR2110_TOTEM.kicad_pcb, GATE_DRIVER_IR2110_TOTEM.kicad_sch]
2026-11-12 TLP250H + tótem: esquemático por bloques con guía de trinchera
    - Esquemático A3 en bloques A–I (entrada, opto alto, opto bajo, 15 V, bootstrap,
    - J2 -> J1, Z1 (antes 1SMA5931B1), redes VB1, HO_TLP, LO_TLP; J5-6 sin conexión
    (antes GND_PUENTE_H, sin uso); D5 como diodo rápido; valores; PWR_FLAG para el ERC
    - README: imagen y sección 0 con TLP250 contra TLP250H (11 mA y sin UVLO:
    solo en la rama A), cuidados al soldar y prueba sin MOSFET
    Claude-Session: https://claude.ai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
    [GATE_TLP_250_TOTEM_TIP.kicad_pcb, GATE_TLP_250_TOTEM_TIP.kicad_sch]
2026-11-12 TLP250H: esquemático y PCB actualizados por el autor (F8 aplicado; se quitó un tramo suelto de P9); imagen del esquemático
    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
    [GATE_TLP_250_TOTEM_TIP.kicad_pcb, GATE_TLP_250_TOTEM_TIP.kicad_sch]
2026-11-12 UCC21520: archivos de KiCad, R3 = 49.9 kΩ, UCC21520DW y README verificado
    - Esquemático por bloques (A–G) y PCB del autor; esquemático = PCB (19/19),
    conectividad completa; proyecto .kicad_pro
    - R3 = 49.9 kΩ 1 %: 500 ns de respaldo por hardware; el driver aplica el
    mayor entre el tiempo muerto del firmware y el de R3 (no se suman)
    - U1 = UCC21520DW (UVLO 8 V) en lugar de la versión A (5 V)
    - README: secciones de tiempo muerto, versión del chip, layout, prueba en banco,
    pendientes, archivos y bitácora; J2-9 = GND reservado
    - UCC21520ADWR -> UCC21520DW en el README principal, los otros módulos y docs
    Claude-Session: https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
    [GATE_DRIVER_UCC21520.kicad_pcb, GATE_DRIVER_UCC21520.kicad_sch]
2026-11-12 Puente H: hoja raíz A3 por bloques, MOSFET canal N, 15V_GB y hojas renombradas
    - Hoja raíz rehecha en A3 por bloques A–I (antes casi todo quedaba fuera de la A4),
    con notas al día y guía rápida de trinchera; conexiones idénticas (pin por pin)
    - Q1–Q4 con símbolo de canal N (antes IRF4905, canal P; pines 1 G · 2 D · 3 S iguales)
    - D1–D4 con símbolo de diodo rápido (antes SS14 Schottky)
    - Red 15V -> 15V_GB (pareja de 15V_GA, como en la tarjeta de control)
    - CAPASITORES -> CAPACITORES, untitled -> DISIPADORES (hojas y PCB)
    - Valores con voltaje y dieléctrico; NC en J3-5 y J9/J10-3, 8, 9; sin buses de adorno
    - PCB: red 15V_GB, nombres de hoja y valores; sin mover huellas ni p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
    [CAPACITORES.kicad_sch, DISIPADORES.kicad_sch, PUENTE_H_INV48V_REV_C_2026-10_GATE_CENTRO.kicad_pcb, PUENTE_H_INV48V_REV_C_2026-10_GATE_CENTRO.kicad_sch]
2026-11-12 Puente H: hoja ESTUDIOS con las 3 láminas (KiCad no abría la raíz por líneas de más de 1 MB); imágenes en img/ y sección 6.1
    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
    [ESTUDIOS.kicad_sch, PUENTE_H_INV48V_REV_C_2026-10_GATE_CENTRO.kicad_sch]
2026-11-12 Puente H: archivos del autor (KiCad 9) + etiqueta VS2 de J22 reubicada al pin tras girarlo 180°
    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
    [CAPACITORES.kicad_sch, ESTUDIOS.kicad_sch, PUENTE_H_INV48V_REV_C_2026-10_GATE_CENTRO.kicad_pcb, PUENTE_H_INV48V_REV_C_2026-10_GATE_CENTRO.kicad_sch]
2026-11-12 Firmware CRÍTICO paso 1: variables de la portadora del SPWM (328P y 4809), salidas seguras y reporte
    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
2026-11-12 Firmware CRÍTICO: explicación de la tabla de un cuarto de onda y del muestreo al centro del periodo
    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
2026-11-12 Firmware CRÍTICO paso 2: SPWM híbrida en ATmega328P (Timer1, cruce por cero, límites), tabla de cuarto de onda generada y prueba en la PC
    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
2026-11-12 Firmware CRÍTICO: soporte de 50 Hz y 60 Hz (portadora fija de 24 kHz, 400/480 muestras, dos tablas de cuarto de onda) con advertencias de transformador y voltaje
    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
2026-11-12 Firmware CRÍTICO: la frecuencia de línea se elige solo en config_portadora.h (sin opción en el SETUP)
    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
2026-11-12 Firmware CRÍTICO: techo absoluto de modulación del 95 % (menor entre techo y límite físico del DT en uso)
    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
2026-11-12 README principal: sección Firmware (CRÍTICO paso 2: SPWM híbrida, 50/60 Hz, LUT, techo 95 %)
    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
2026-11-12 Firmware CRÍTICO: analiza_captura.py para validar la SPWM real con analizador lógico de 24 MHz (sección 7.1)
    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
2026-11-12 Firmware CRÍTICO: primera prueba real en Nano validada con analizador lógico (60.04 Hz, DT 1000 ns, LB 49.75 %); capturas en img/
    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
2026-11-12 Firmware CRÍTICO: tiempo muerto de la pierna B marcado como pendiente de medir en banco
    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
2026-11-12 Firmware CRÍTICO: tiempo muerto de la pierna B medido en banco, HB ↓ → LB ↑ = 42 µs (LB ↓ → HB ↑ pendiente)
    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
2026-11-12 Firmware CRÍTICO: pierna B HB ↓ → LB ↑ medida con zoom = 42.000 µs
    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
2026-11-12 Firmware CRÍTICO: pierna B LB ↓ → HB ↑ medida = 42.188 µs; paso 2 validado en Nano real
    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
2026-11-12 Firmware CRÍTICO: tercera medición de la pierna B (41.751 µs); la variación se explica por la latencia de la interrupción
    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
2026-11-12 Firmware CRÍTICO: captura de 2 M muestras; pierna B entre 40.437 y 42.188 µs en 5 cruces, 60.04 Hz estable
    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
2026-11-12 Firmware CRÍTICO: pulso solitario de HA medido en banco (nivel fijado en BOTTOM); modelo de la PC corregido y verificado
    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
2026-11-12 Firmware CRÍTICO: prueba real a 50 Hz validada (50.033 Hz, LB 49.79 %, DT 1000 ns, pierna B ~42 µs)
    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
2026-11-12 Firmware CRÍTICO: ETAPA BASE COMPLETADA, generación de la SPWM híbrida validada en hardware real a 50 y 60 Hz
    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
2026-11-12 Firmware CRÍTICO: método de validación aclarado (medición manual en PulseView; analiza_captura.py opcional, aún sin capturas reales)
    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
2026-11-12 Firmware CRÍTICO: tiempo muerto de 500 ns validado en hardware real a 60 Hz (dos flancos); sección 7.0c
    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
2026-11-13 Tarjeta de control: mapa de pines del CRÍTICO y del AUX (verificado contra el esquemático), con estado al encender, timer dueño y reglas de firmware
    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
2026-11-13 Firmware CRÍTICO: gráfica de la LUT de 90° por cuadrantes (4 colores) en el README
    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
2026-11-13 Firmware CRÍTICO: nota de trigonometría de bachillerato aplicada (75 % menos tabla) en la gráfica y el README
    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
2026-11-13 Firmware CRÍTICO: nota de la LUT con la frase del autor (las matemáticas maximizan los recursos en la trinchera)
    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
2026-11-13 Firmware CRÍTICO: nota de la LUT con la frase nueva del autor (SPWM de trinchera sin coprocesador ni hardware dedicado)
    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
2026-11-13 Firmware CRÍTICO paso 3: lectura de P9 en A7 (DT por módulo, vigilancia), prueba en la PC y guía de banco
    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
2026-11-13 Firmware: enlace I2C CRÍTICO (esclavo 0x20) ↔ AUX (maestro) validado en banco, con avisos, recuperación del bus y advertencia de lazo de tierra
    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
2026-11-13 Firmware: justificación de los dos microcontroladores y del enlace I2C (DC-010, DC-017, números medidos)
    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
